LVH-27/S3-ROV/2016/stream_site/01/files/pic01.jpg

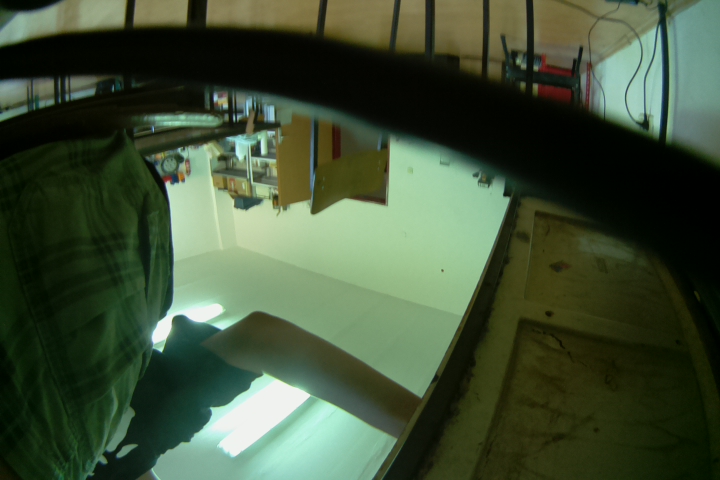
2016/stream_site/01/files/pic01.jpg
