LVH-27/S3-ROV/skladiste/s3 2015/C-ROV.pptx

## C-ROV

Sea Remotely Operated Vehicle

Luka Banović, Nikola Banović, Lovro Boban, Marko Lazarić

Mentori:
Danko Marušić, Dominik Barbarić

## Cilj

- Izrada ROV-a (Remotely Operated Vehicle)
  - Kućište i motori
  - Software
  - Hardware (elektronički sklopovi)
- Primjena:
  - Istraživanje morskog dna (Bromboli, ušće Mirne...)

Sustav za kontrolu

## Kućište

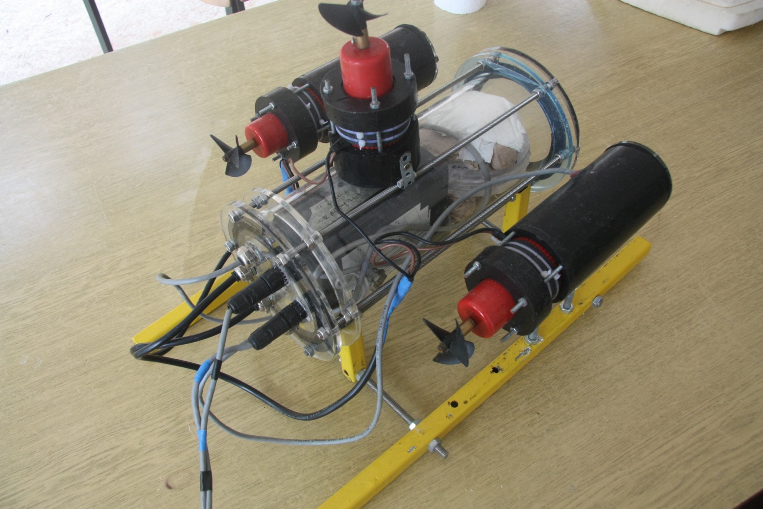
[picture p3: figure]

Gornji motor

Trup

Bočni motor

Postolje

Slika 1. Dijelovi kućišta ROV-a

Ethernet kabel

## Slide 4

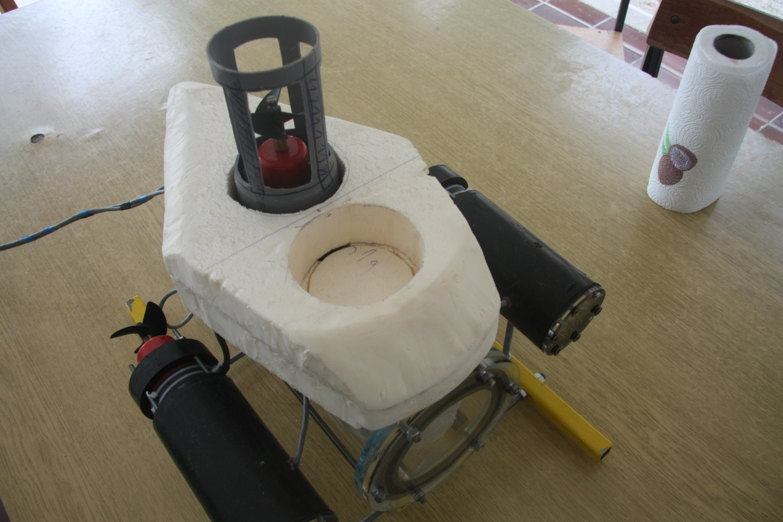
[picture p4: figure]

Slika 2. Stiroporom se prilagođava gustoća podmornice

## Sustav za kontrolu ROV-a

PC

Raspberry Pi

Arduino

Motor

Relej

Electronic Speed Controller (ESC)

Slika 3. Shema sustava za kontrolu ROV-a

## Raspberry Pi

- Server, C++
- Pokret gljivica na joysticku = 3 broja koja određuju brzinu i smjer ROV-a

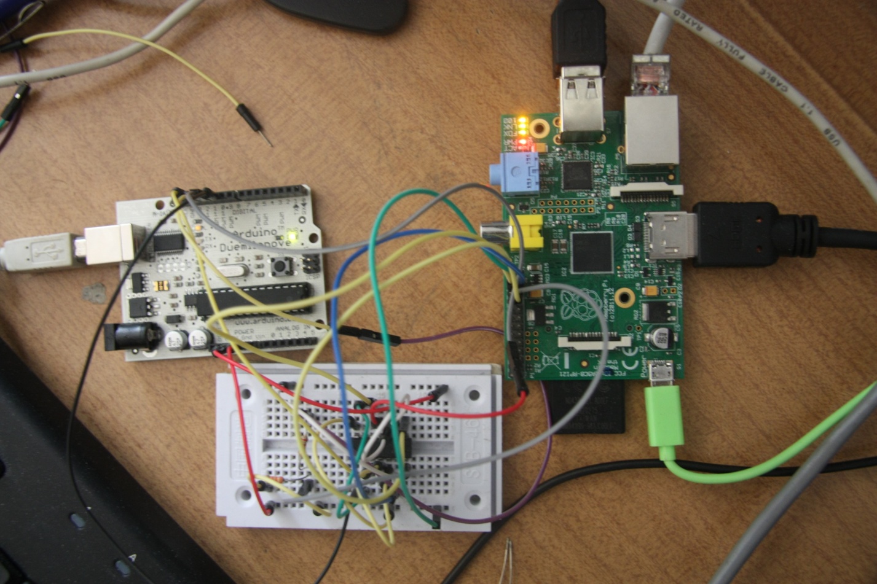
[picture p5: figure]

Slika 9. Raspberry Pi i Arduino spojeni za SPI komunikaciju

## Hardver

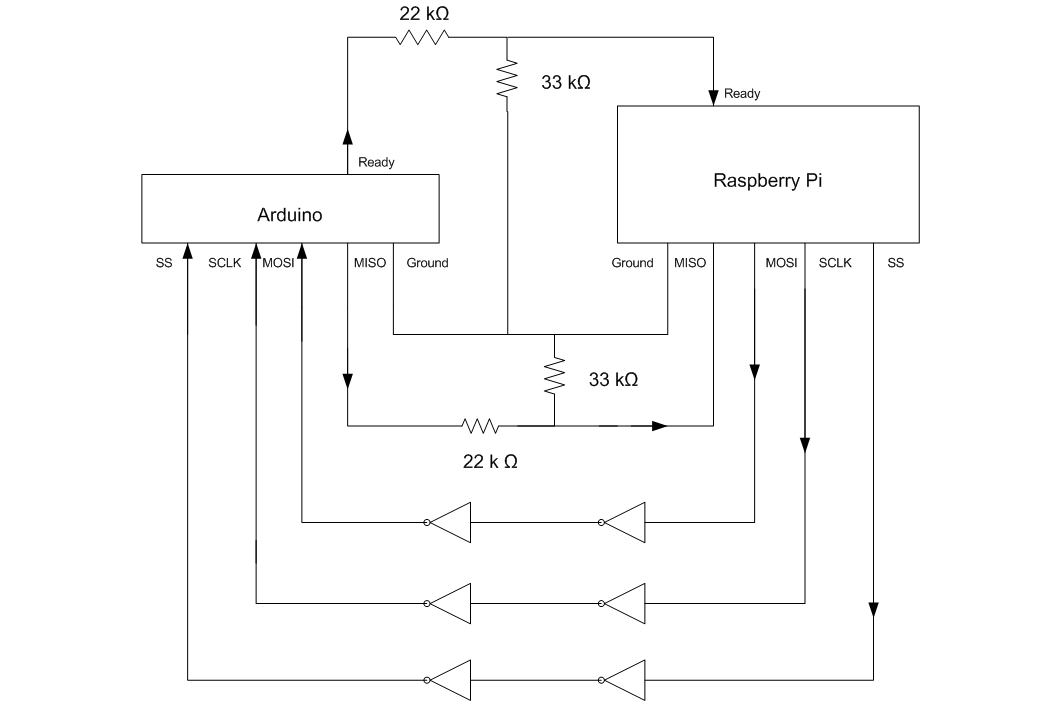
[picture p6: figure]

Slika 4. Komunikacija Arduina i Raspberry Pija

Problem: Arduino i Raspberry Pi ne rade na istom naponu

## Hardver

Problem: ESC ne može mijenjati smjer

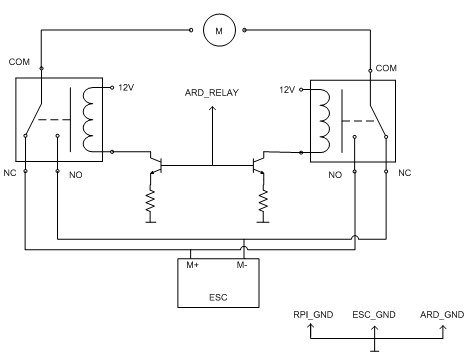
[picture p7: figure]

Slika 5. Shematski prikaz kontrole smjera ROV-a

## Slide 9

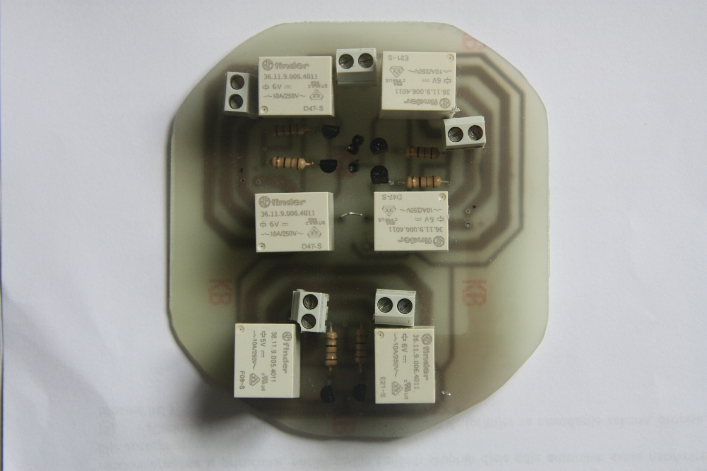
[picture p8: figure]

Slika 8. Tiskana pločica za releje

## Arduino

- Kontrola brzine i smjera ROV-a

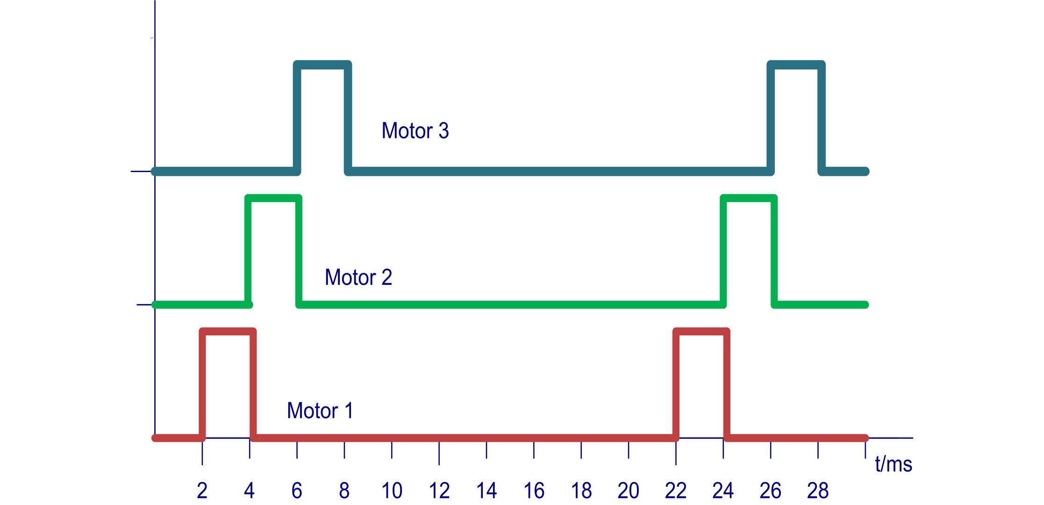
[picture p9: figure]

Slika 10. Grafički prikaz upravljačkih signala za ESC-ove

## Što dalje radimo?

- Izrada tiskane pločice za povezivanje RPi-a i Arduina
- Ispitivanje upravljačkog sustava ROV-a
- Ispitivanje kamere
- Balansiranje ROV-a u morskoj vodi
- Senzorika

## Pitanja?
