LVH-27/S3-ROV/skladiste/s3 2015/ROV - final.pdf

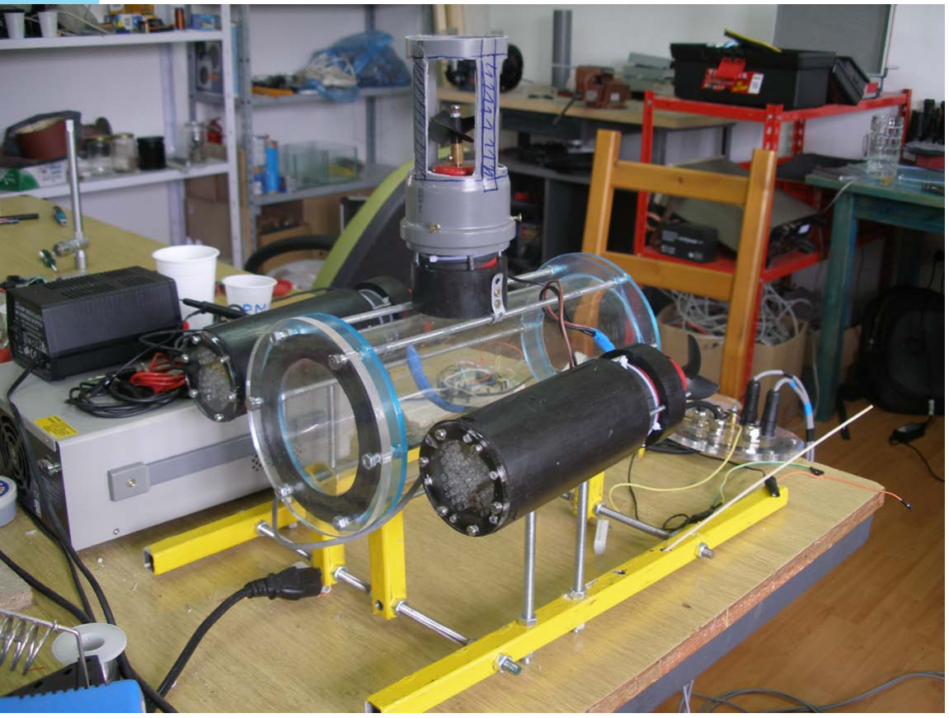
[picture p16: figure]

# ROV

Tara Šverko, Jakov
Jelenić, Daniel Silađi
Mentori: Danko Marušić,
Dominik Barbarić

## Što radimo i što su nam ciljevi?

- Pravljenje ROV-a (Remotely Operated Vehicle), operativnog na dubinama do 30m
- 3 dijela:
- Hardware
- Elektronika
- Software
- Primjena: istraživanje morskog dna

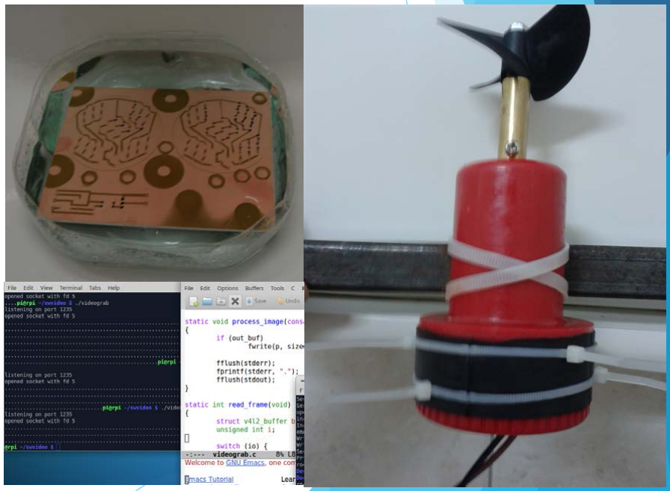
[picture p17: figure]

## Hardware

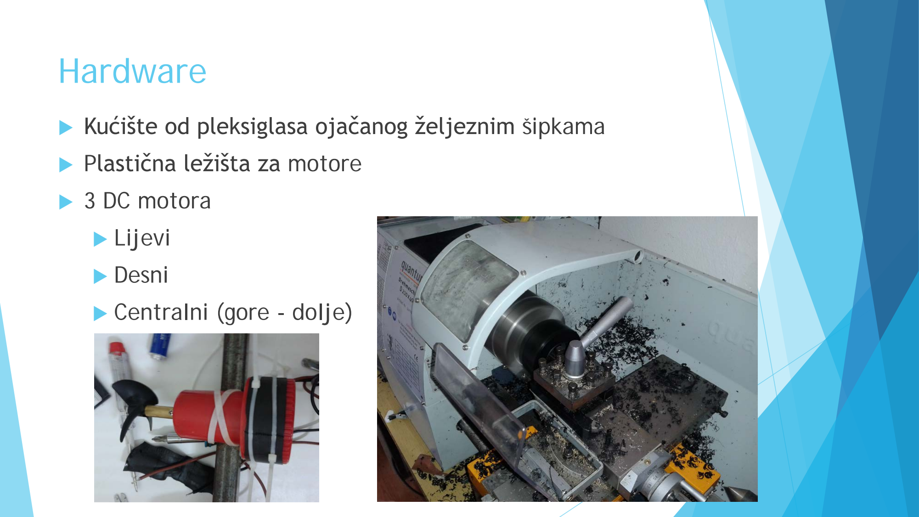
[picture p18: page 3]

- Kućište od pleksiglasa ojačanog željeznim šipkama
- Plastična ležišta za motore
- 3 DC motora
- Lijevi
- Desni
- Centralni (gore - dolje)

## Izazovi

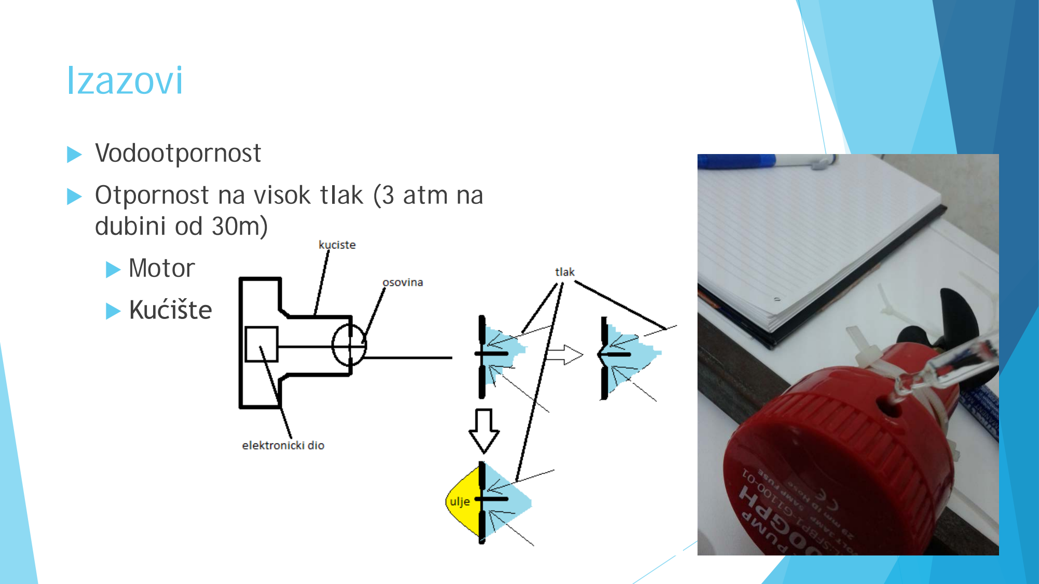
[picture p19: page 4]

- Vodootpornost
- Otpornost na visok tlak (3 atm na dubini od 30m)
- Motor
- Kućište

## Testiranje hardwarea

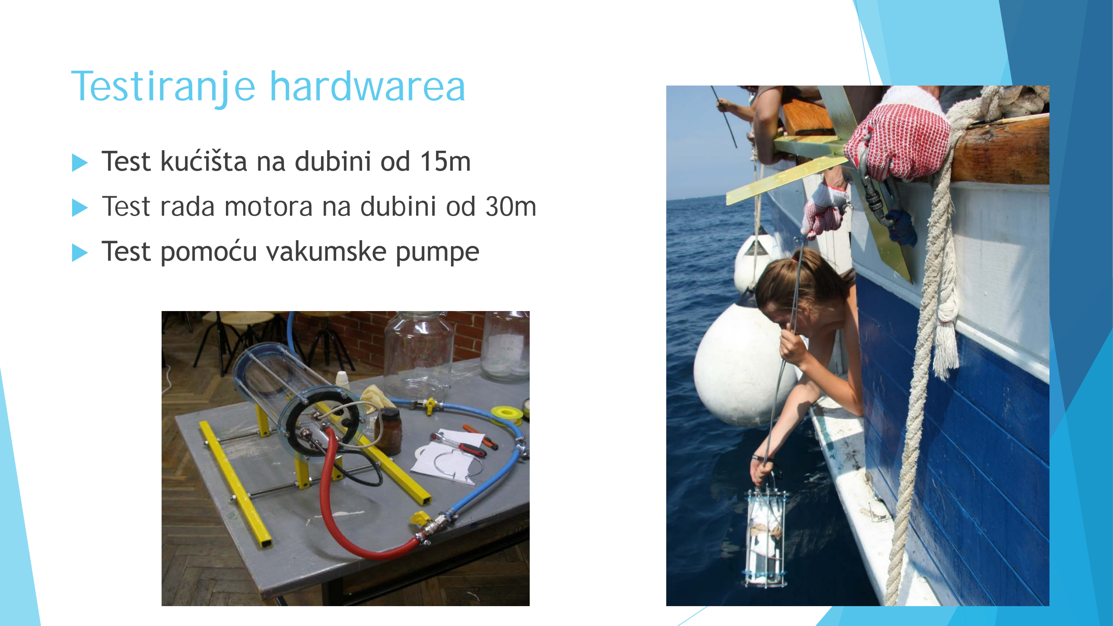
[picture p20: page 5]

- Test kućišta na dubini od 15m
- Test rada motora na dubini od 30m
- Test pomoću vakumske pumpe

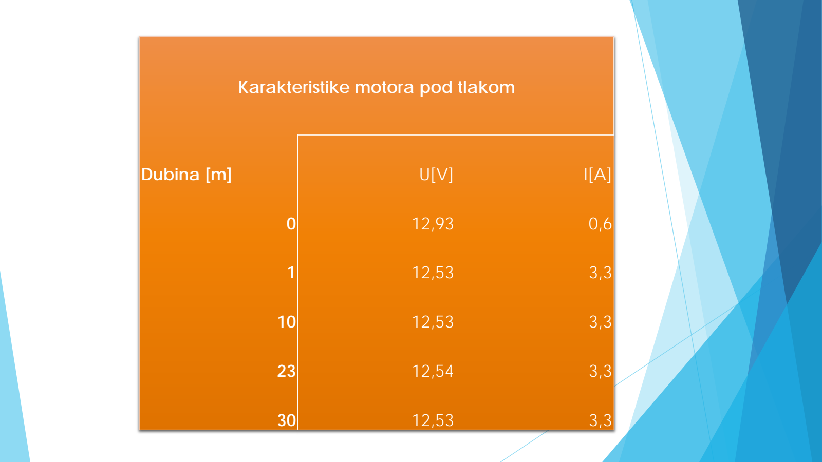
[picture p21: page 6]

Karakteristike motora pod tlakom

Dubina [m] | U[V] | I[A]
0 | 12,93 | 0,6
1 | 12,53 | 3,3
10 | 12,53 | 3,3
23 | 12,54 | 3,3
30 | 12,53 | 3,3

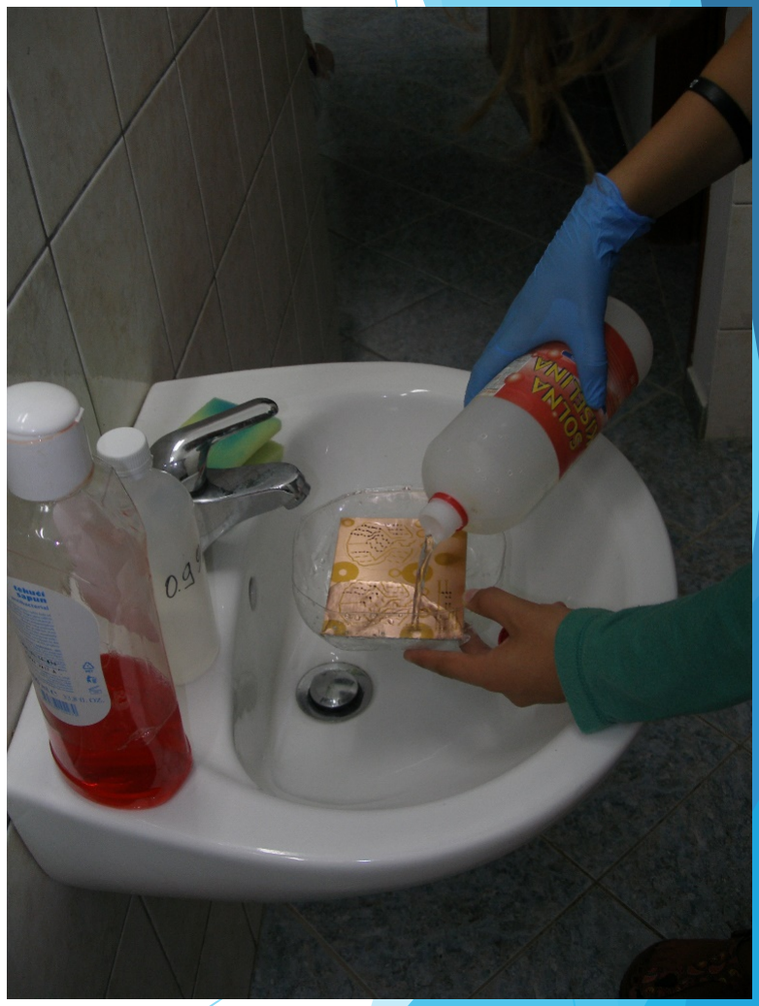
[picture p22: figure]

## Elektronika

- Interface između motora i Raspberry Pi računala
- Potrebno je kontrolirati smjer i brzinu okretanja motora
- Pulse wIdth modulacija
- H – most
- Sami smo izradili svoje PCB-ove
- Dodatna elekronika
- Rasvjeta
- Regulator napona za Raspberry Pi

## Pulse Width Modulation (PWM)

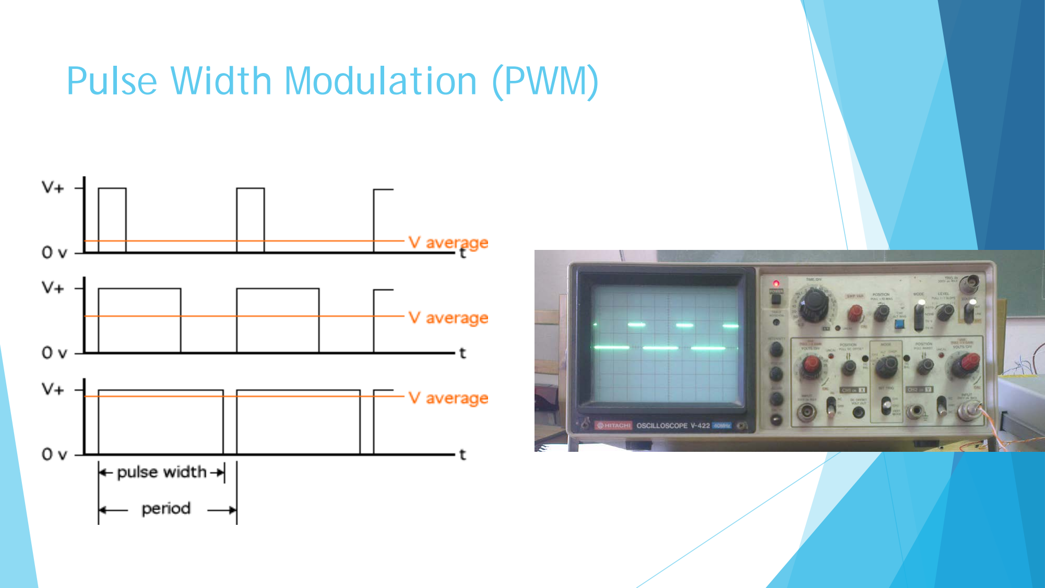
[picture p23: page 8]
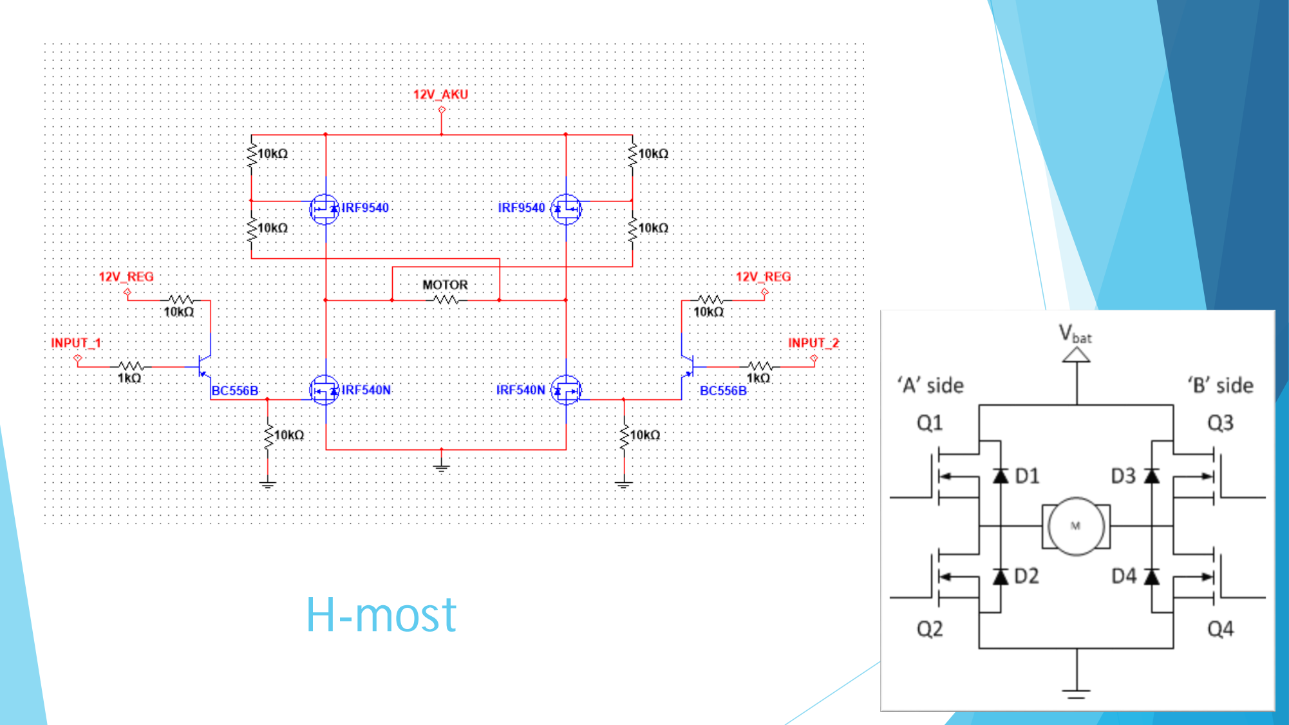
[picture p24: page 9]

## H-most

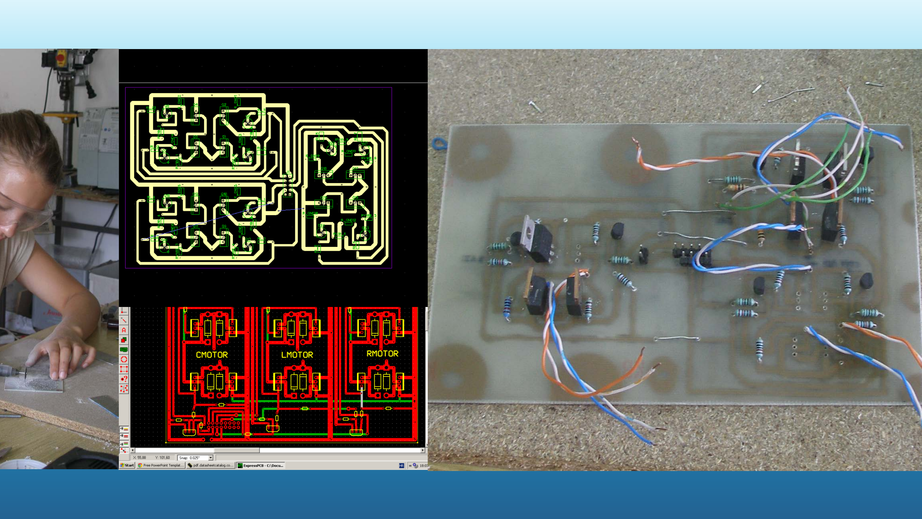
[picture p25: page 10]

## LED rasvjeta

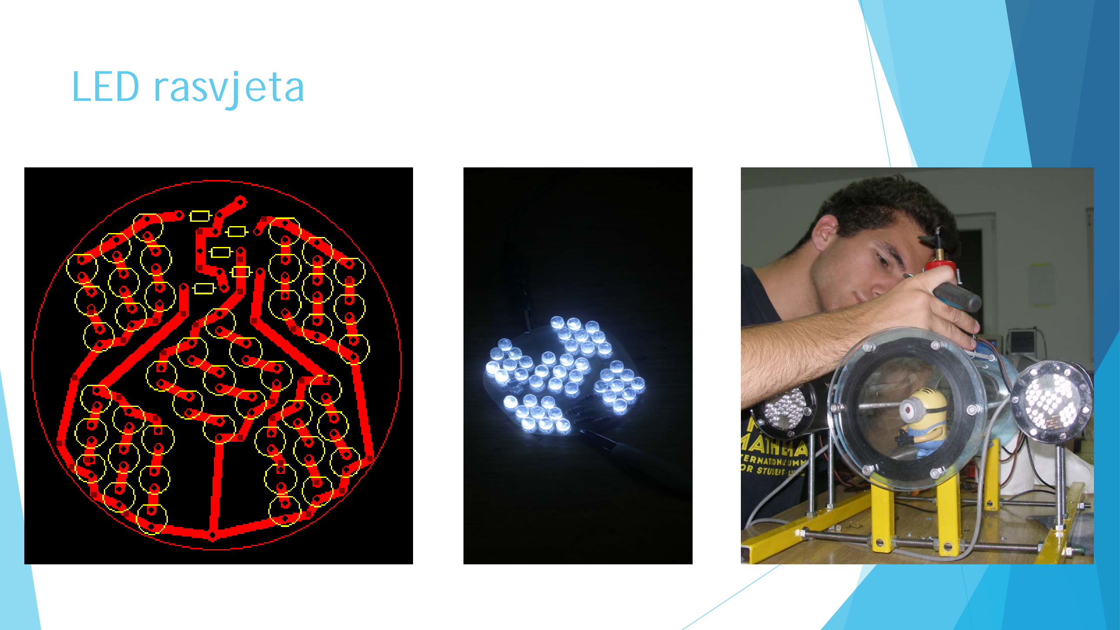
[picture p26: page 11]

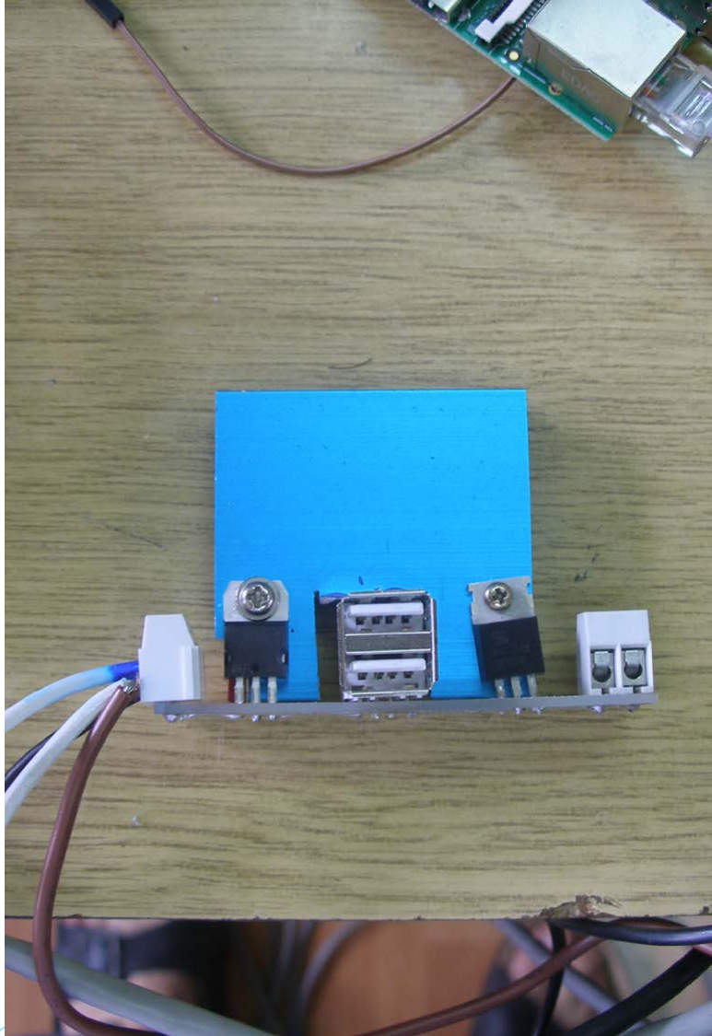
[picture p27: figure]

## Regulator napona

- Napunjeni akumulator nam daje više od 12V
- Regulator nam osigurava stabilnih 12V i stabilnih 5V (za Raspberry Pi)
- Koristili smo sklopove 7805 i 7812

## Software

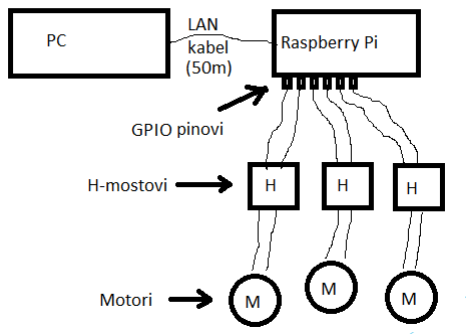
[picture p28: figure]

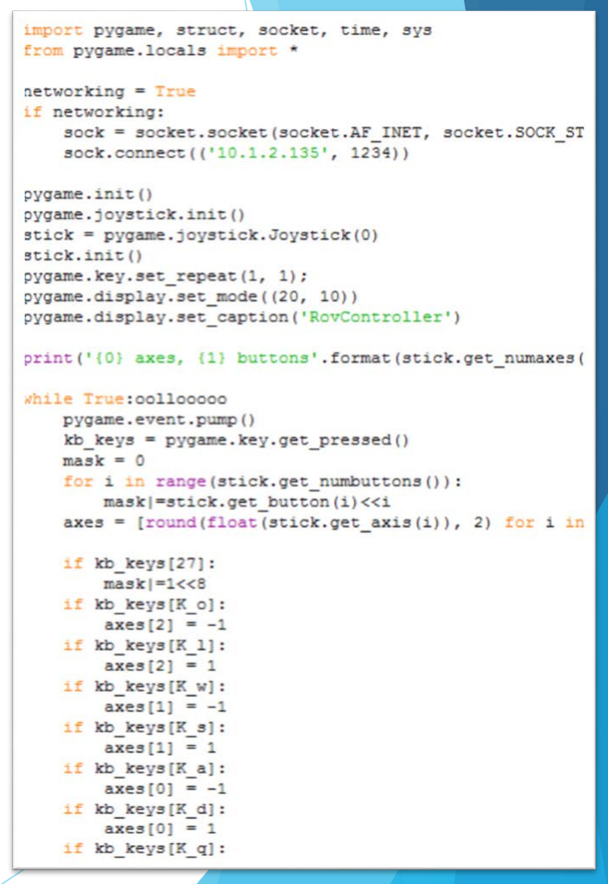
[picture p29: figure]

## Kontroliranje ROV-a

- Klijent – server arhitektura
- Klijent periodično šalje stanje gumbova na joysticku (biblioteka pyGame)
- Server (također periodično) obrađuje te podatke i na osnovu njih pali i gasi motore
- Ukoliko ne želimo pokretati motore punom snagom, šaljemo PW moduliran signal

## Kamera

- Cilj je da ROV prenosi livestream koji će olakšati upravljanje i navigaciju
- Idealno bi bilo prenositi video u HD rezoluciji, pri bar 30fps
- Ograničeni smo brzinom Ethernet kabla (100Mbps) i procesorskom snagom Rpi (ARM11@700Mhz)
- Kompromis: nekompresirani VGA video pri 15fps
- Sav prijenos podataka se vrši preko TCP

## Planovi za dalji rad

- Kratkoročni
- Izraditi novi elektronski sklop na tiskanoj pločici
- Hardversko enkodiranje videa sa web kamere
- Dugoročni
- Primjena u istraživanjima
- Adaptiranje kućišta na veće dubine i ostale posebne uvjete
- Povezivanje sa prošlogodišnjim projektom izrade robotske ruke

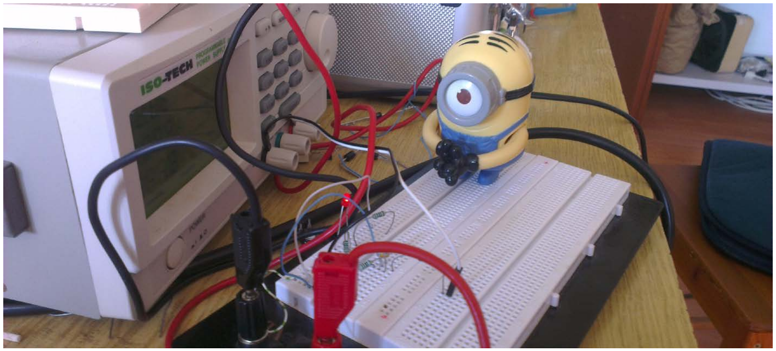
[picture p30: figure]

Hvala na pažnji, pitanja?
