LVH-27/S3-ROV/skladiste/s3 2015/graf novi.png

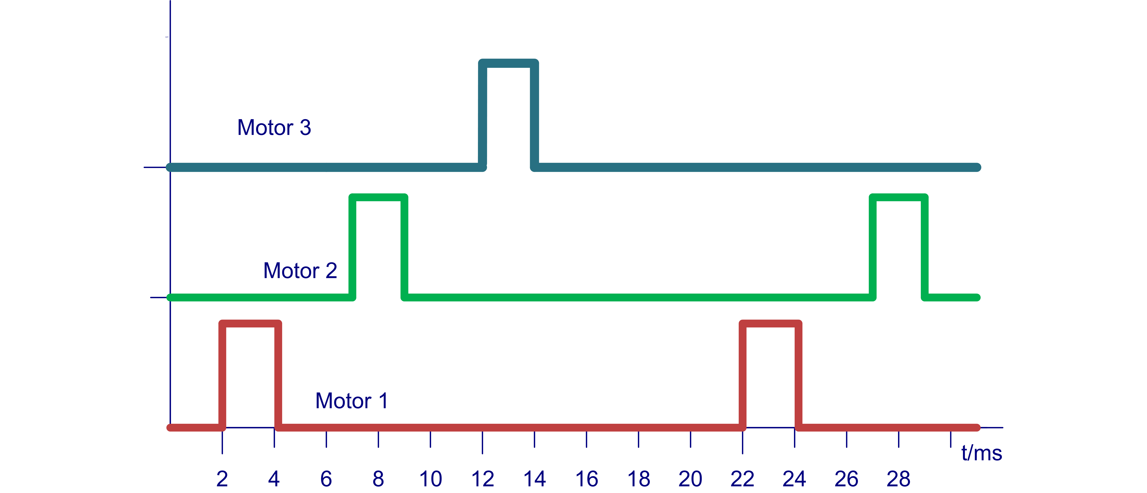
skladiste/s3 2015/graf novi.png
