LVH-27/S3-ROV/skladiste/s3 2015/pico slik/2015_08_04_004.bmp

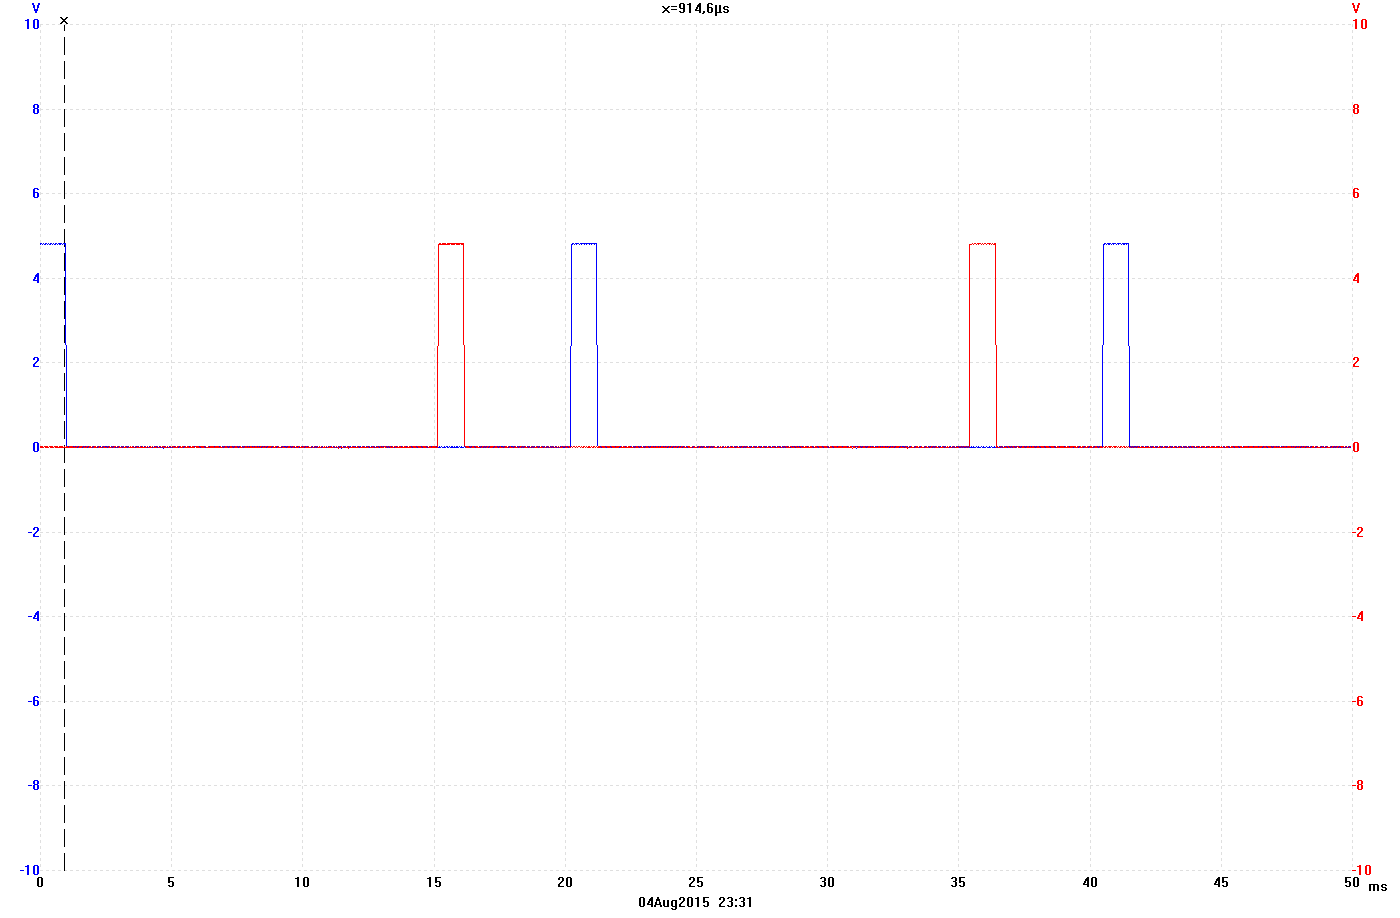
skladiste/s3 2015/pico slik/2015_08_04_004.bmp
