LVH-27/S3-ROV/skladiste/s3 2015/untitled.PNG

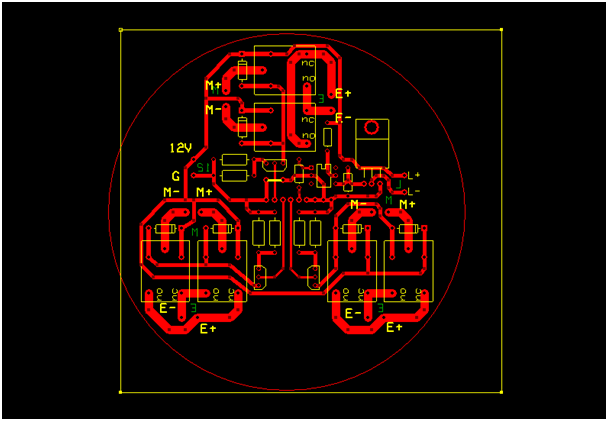
skladiste/s3 2015/untitled.PNG
