LVH-27/S3-ROV/2016/ROV_PCB/Job1.PDF

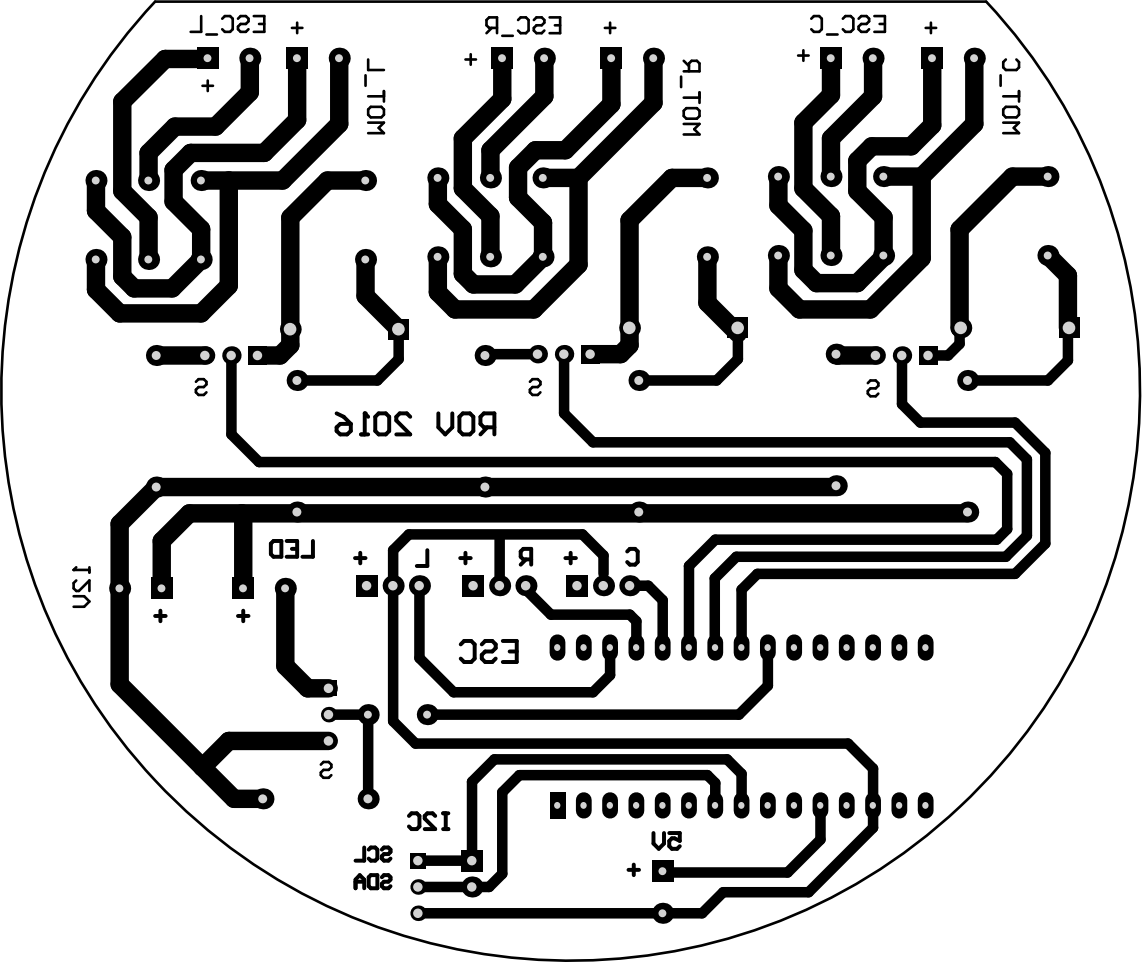
[picture p37: page 1]

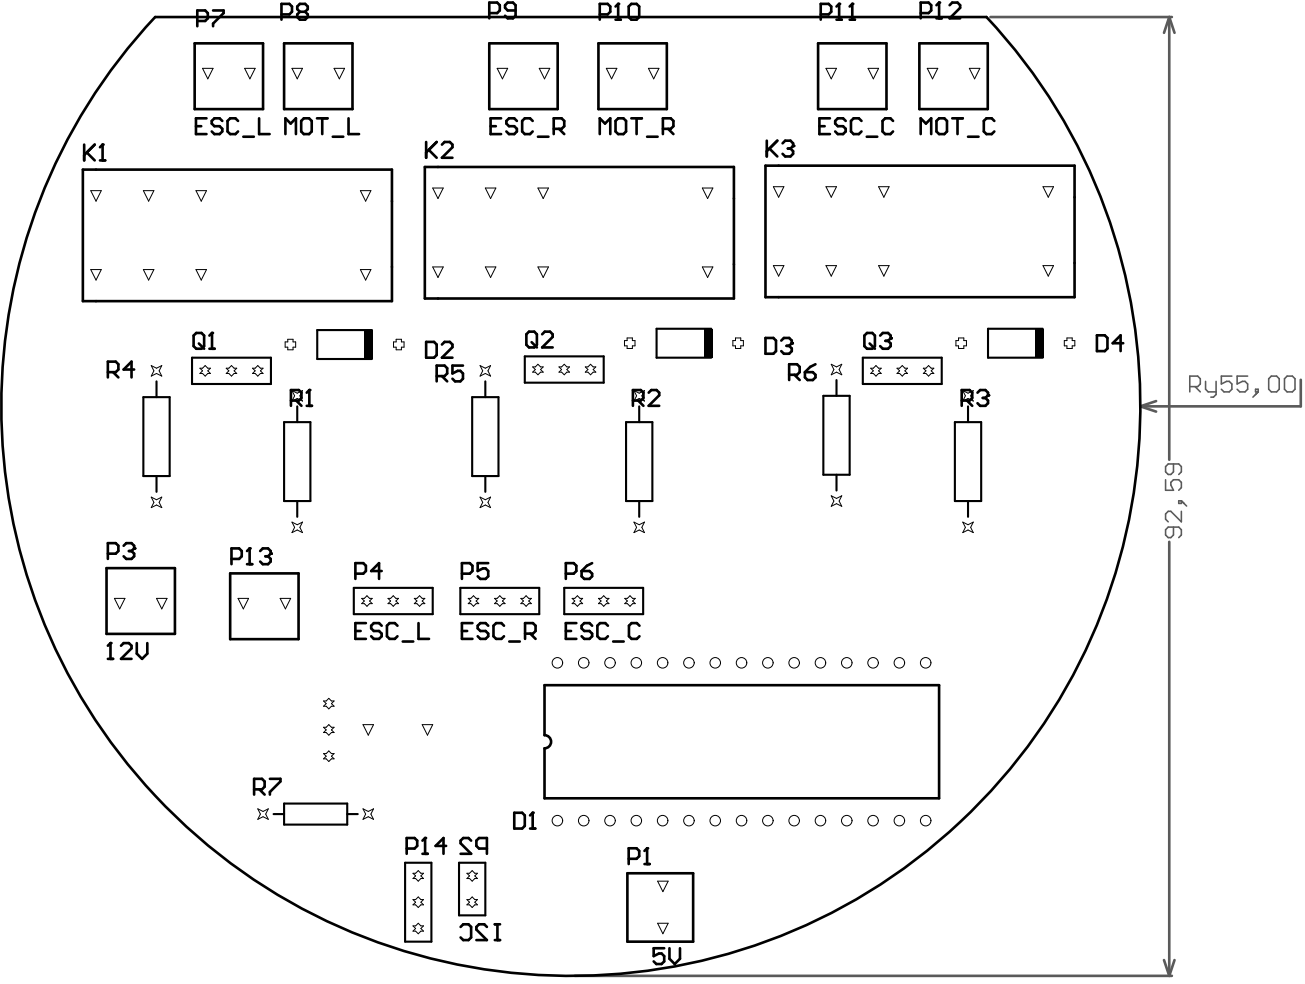
[picture p38: page 2]
