LVH-27/S3-ROV/2016/ROV_PCB/job1_scaled.pdf

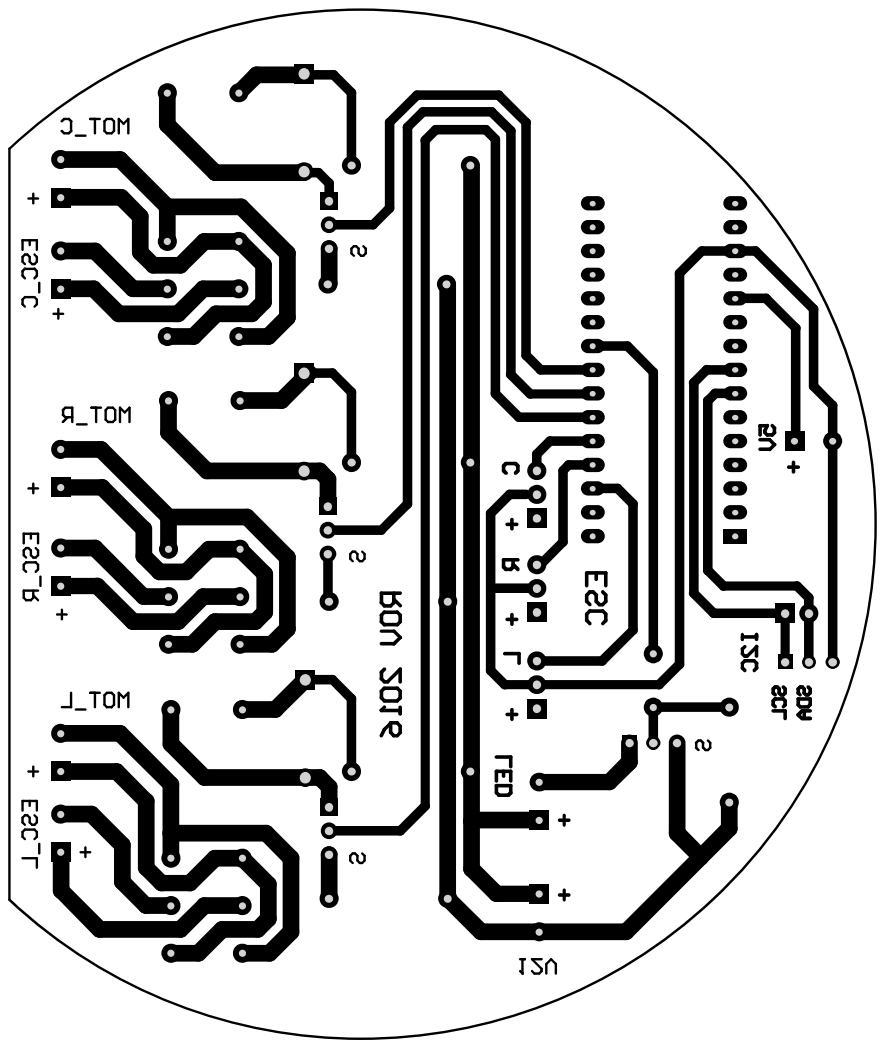
[picture p39: page 1]

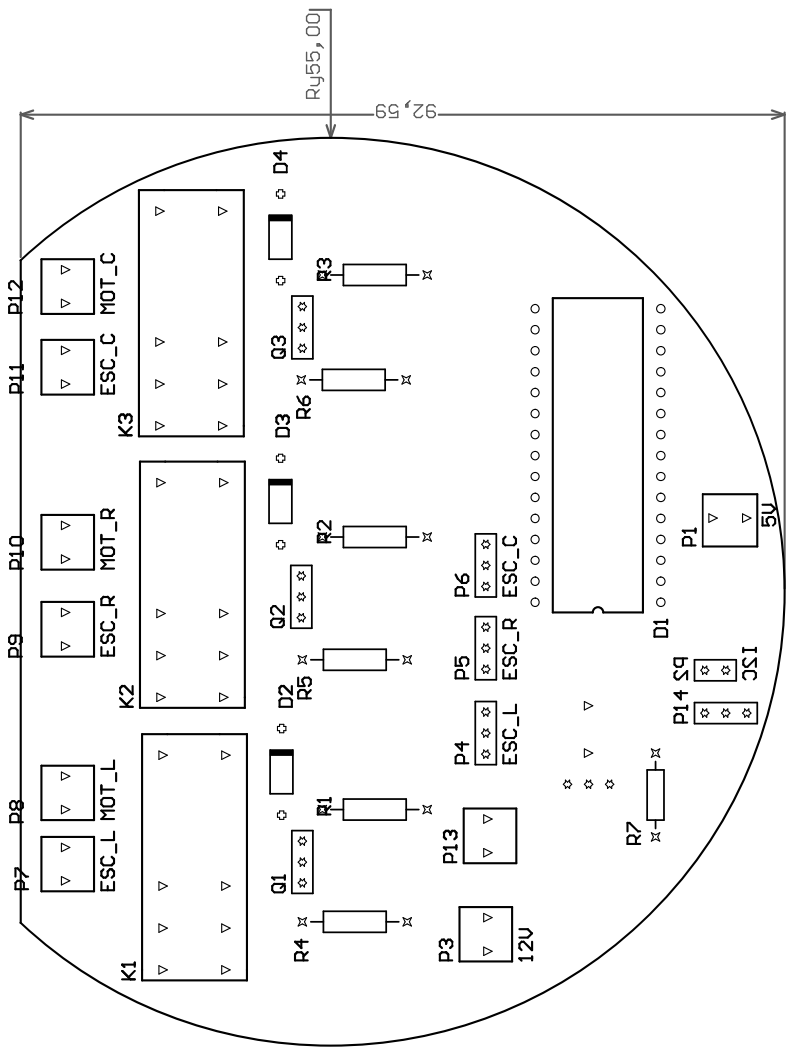
[picture p40: page 2]
