LVH-27/S3-ROV/2017/hw/EDIT-ROV-HEHEHE.PDF

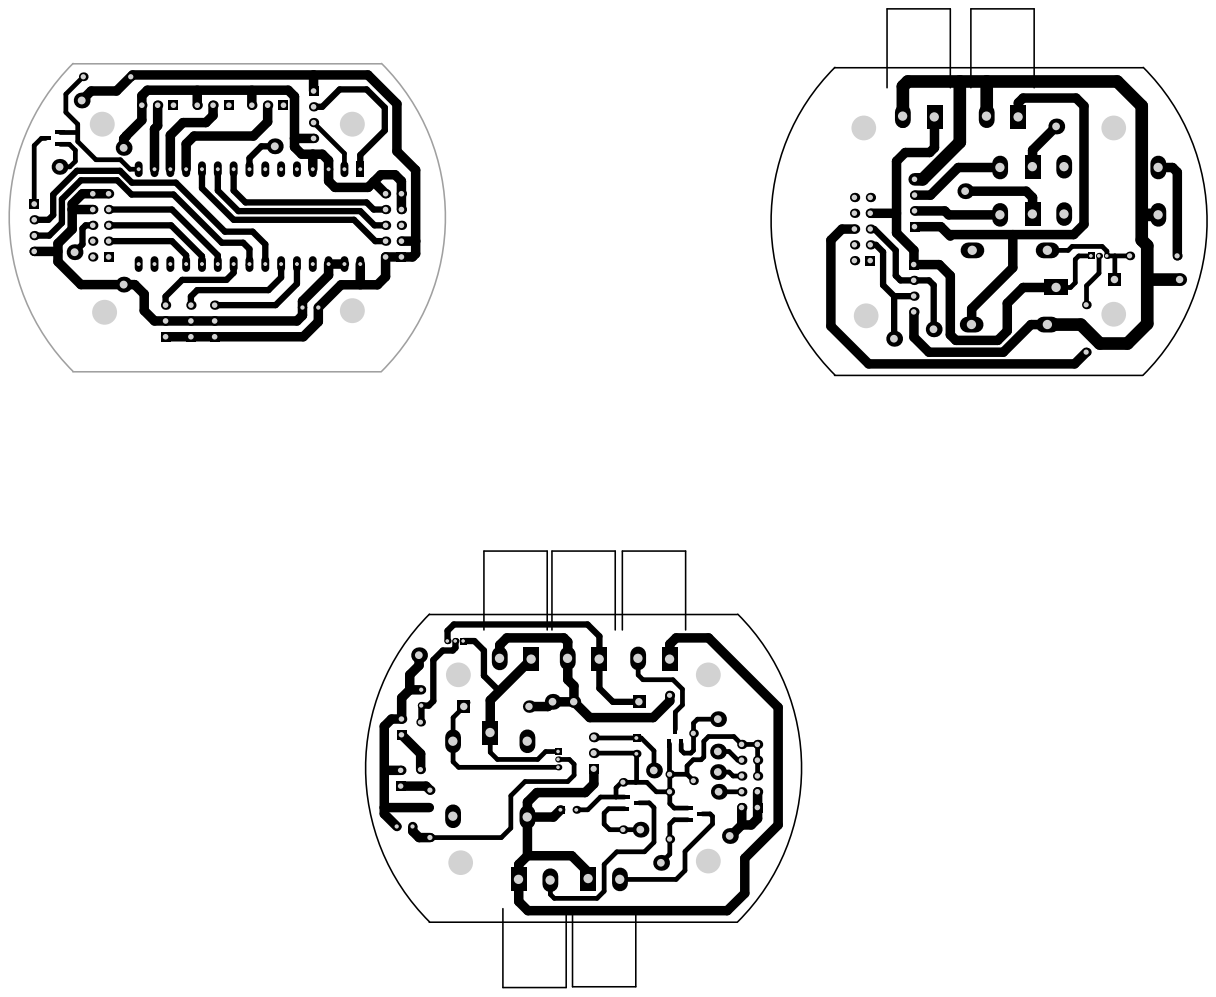
[picture p41: page 1]
