LVH-27/S3-ROV/2017/hw/EDIT-ROV-HEHEHE2.PDF

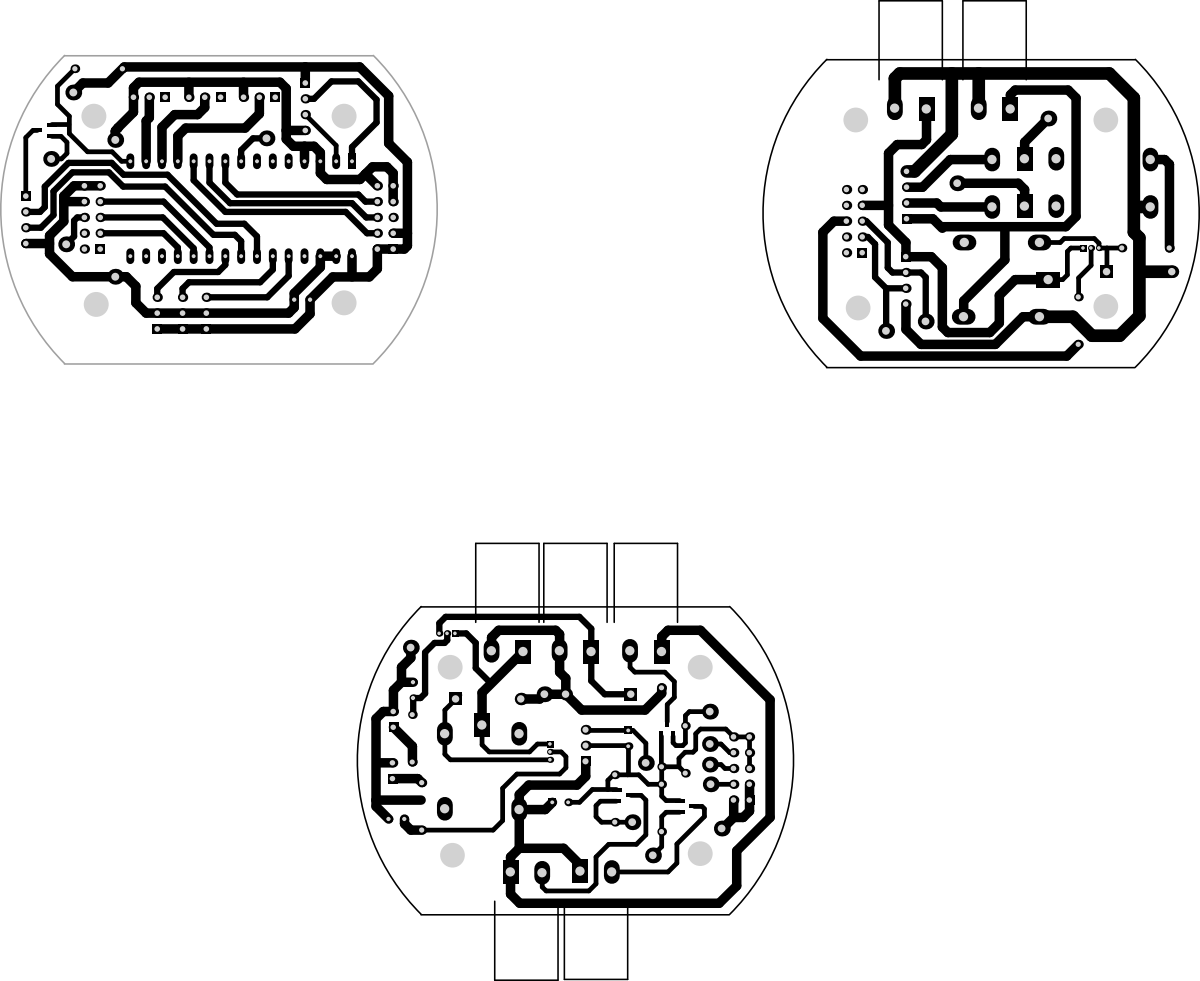
[picture p42: page 1]
