LVH-27/S3-ROV/2017/hw/NO EDIT - ROV/Project Outputs for ROV_PCB_3/Job1.PDF

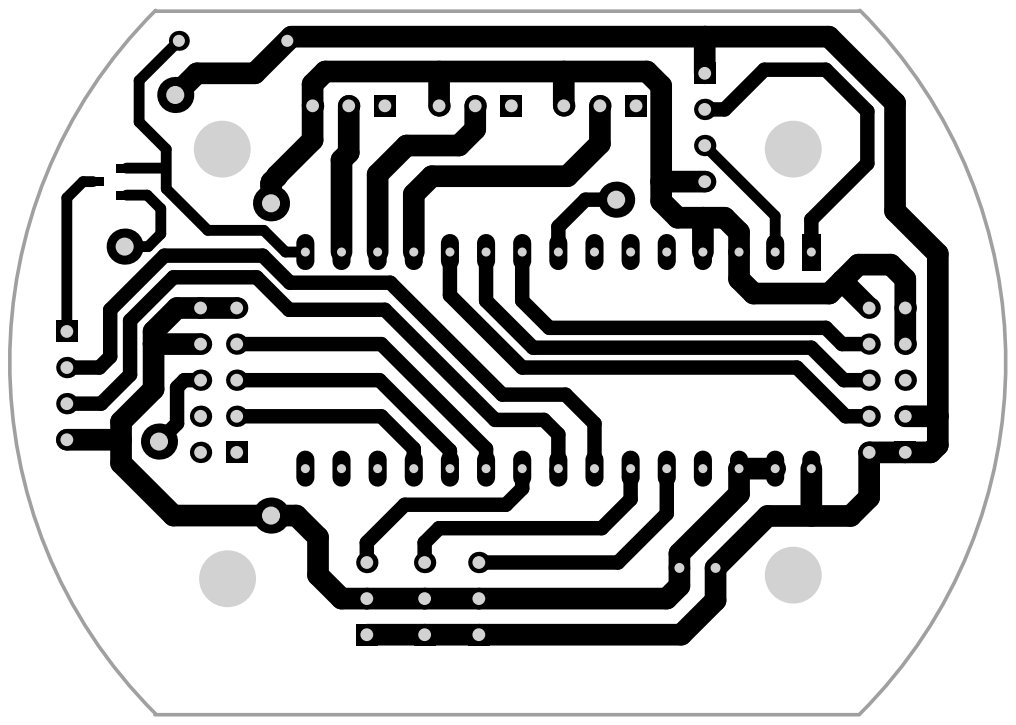
[picture p43: page 1]

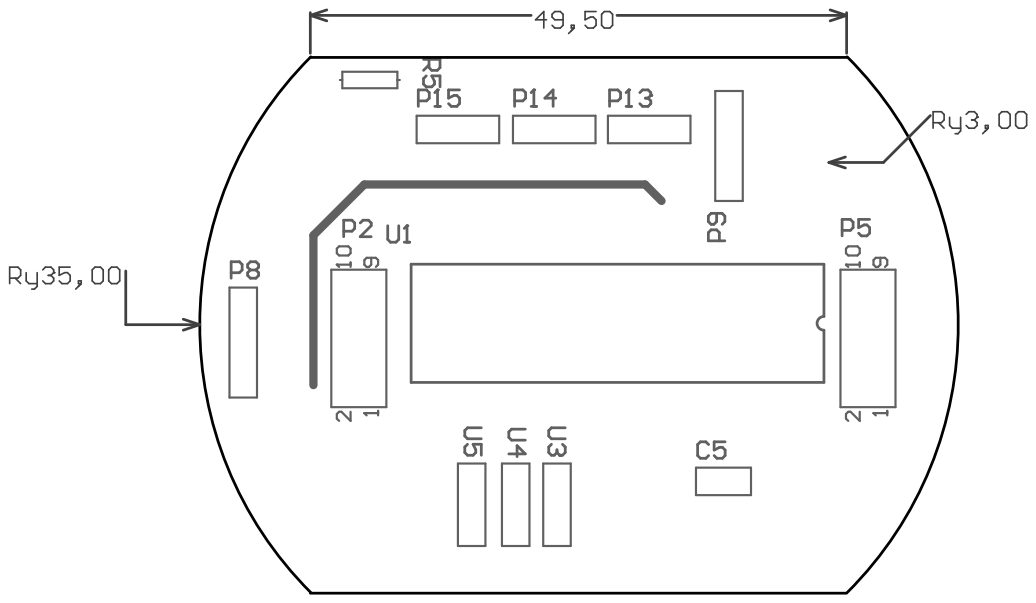
[picture p44: page 2]

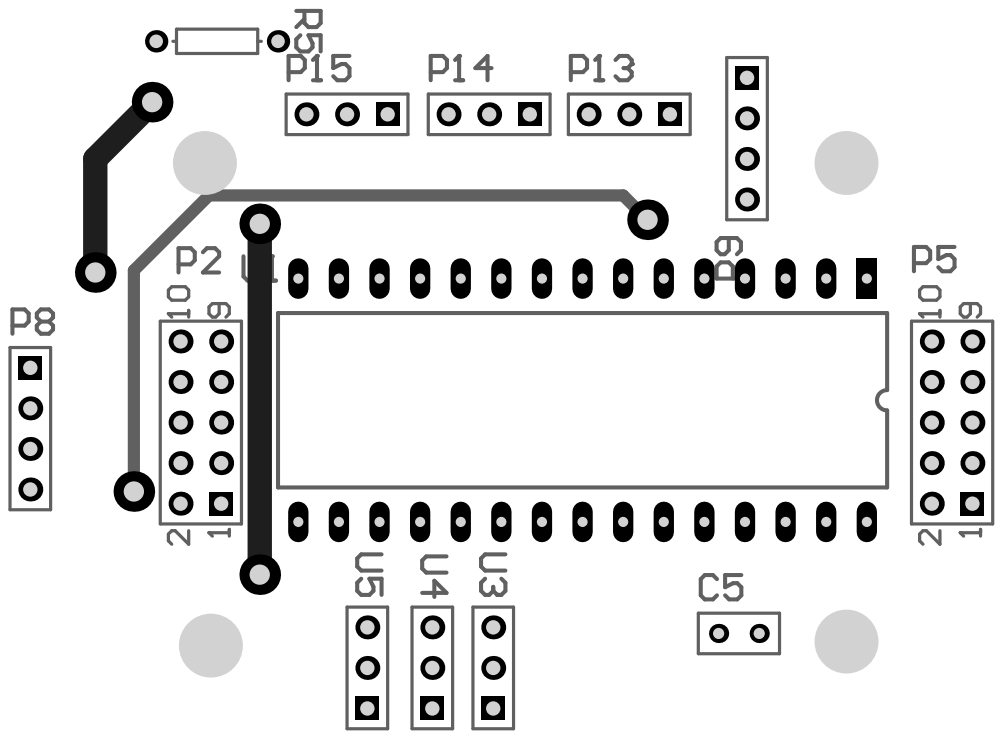
[picture p45: page 3]

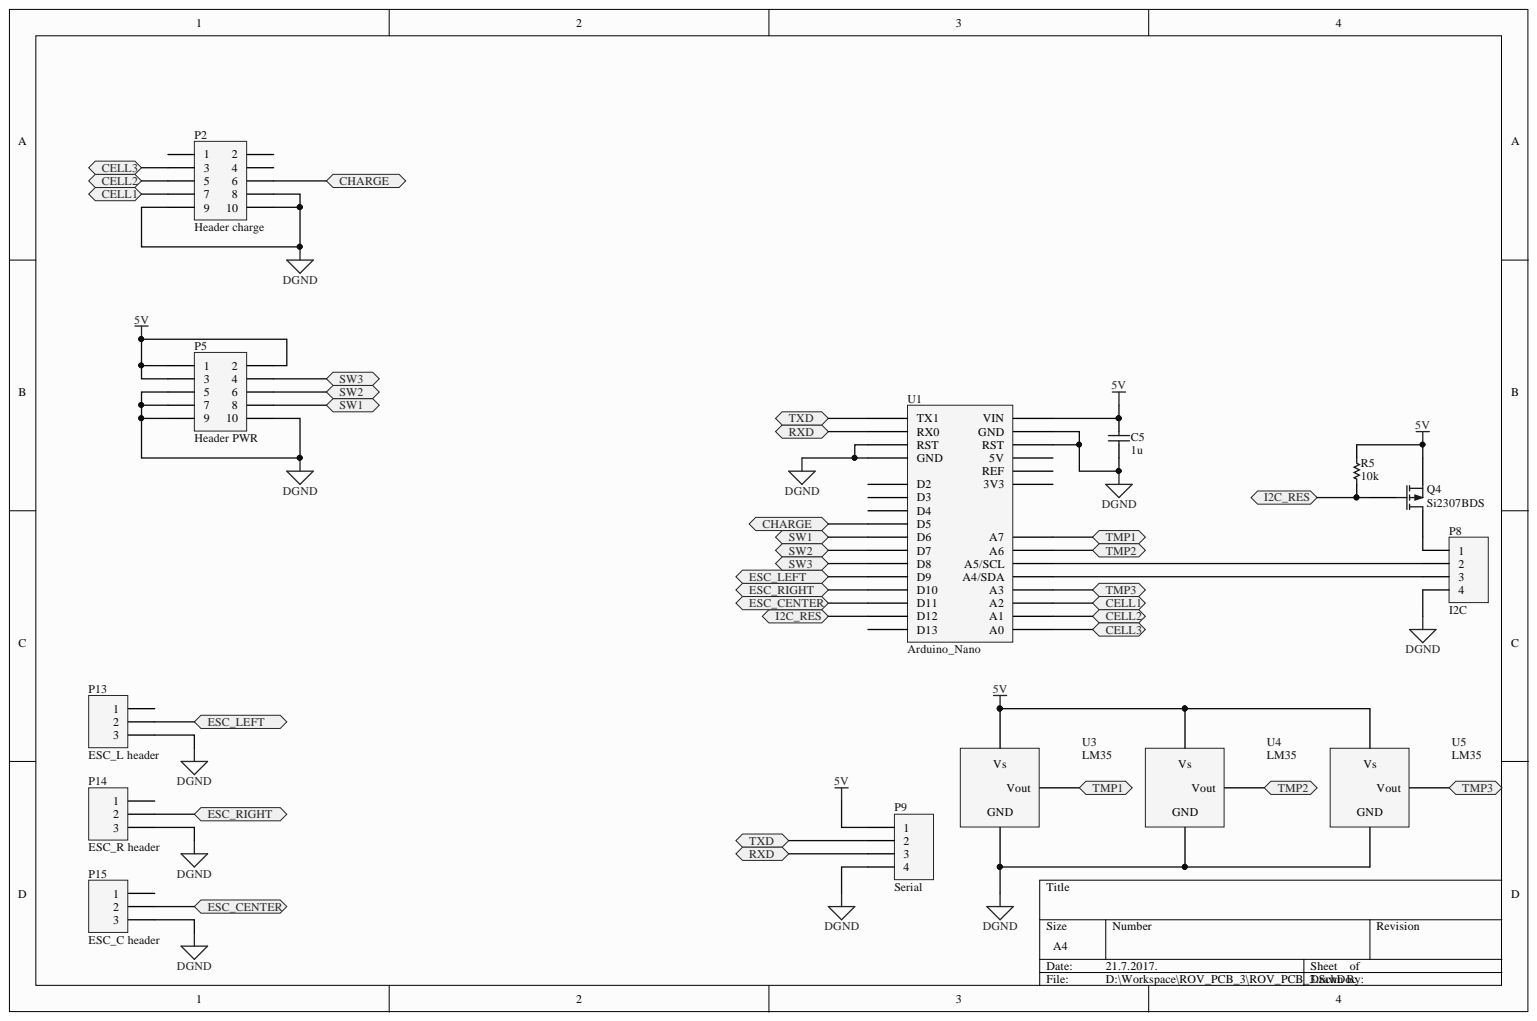
[picture p46: page 4]
