LVH-27/S3-ROV/2017/hw/NO EDIT - ROV/ROV_PCB_CHARGE/Job1.PDF

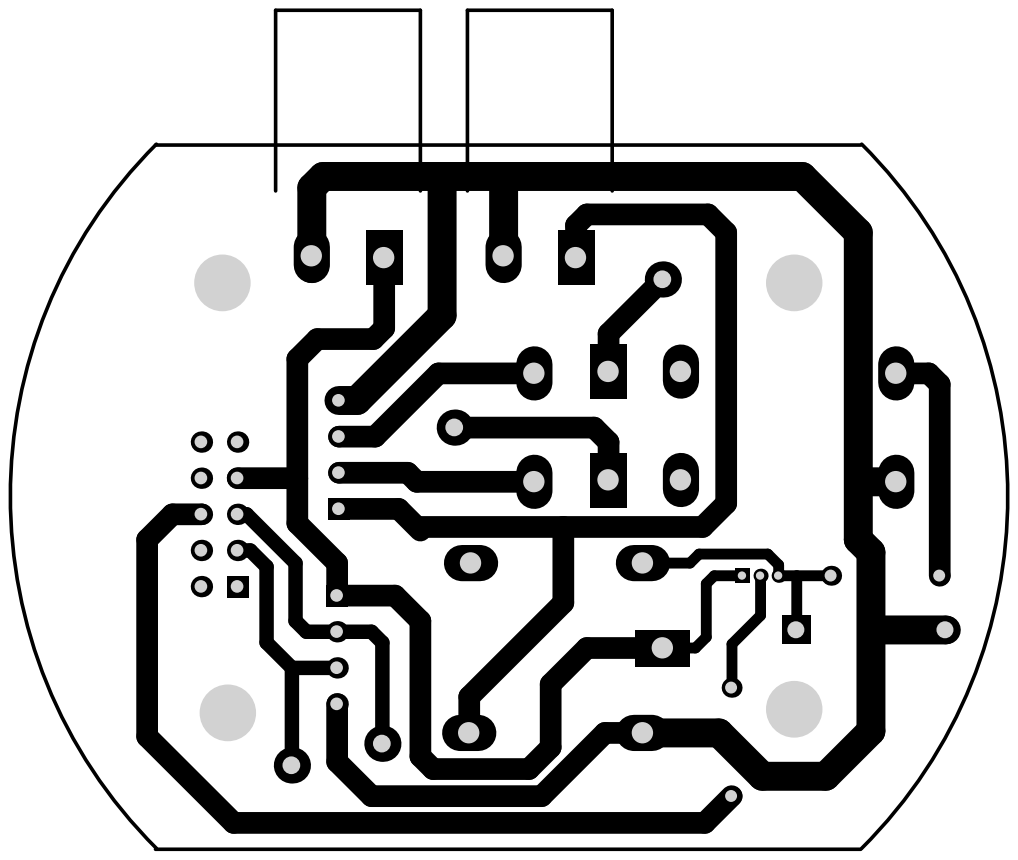
[picture p47: page 1]

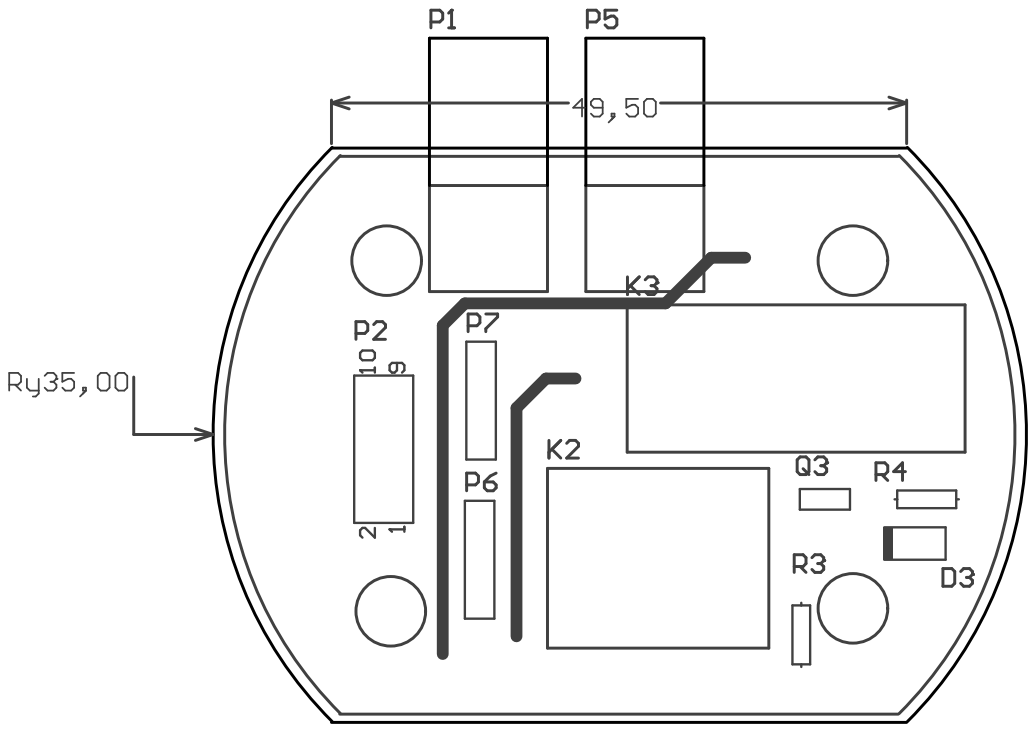
[picture p48: page 2]

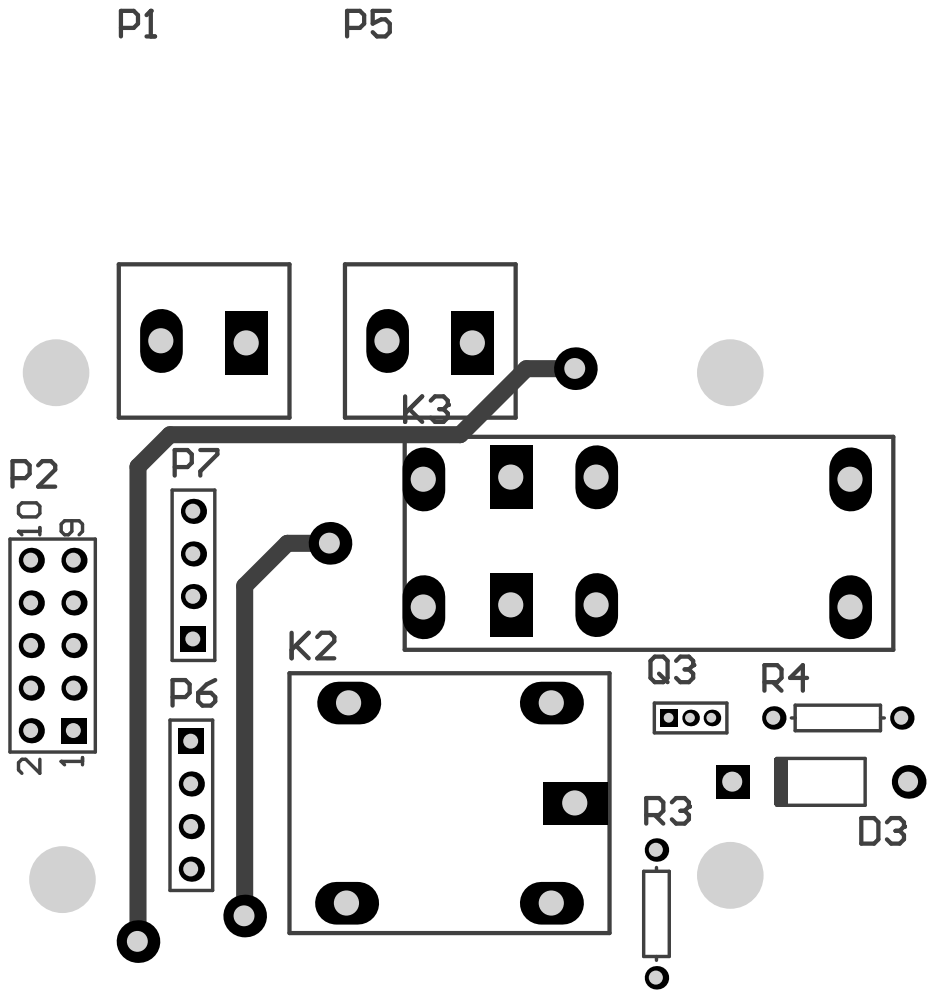
[picture p49: page 3]

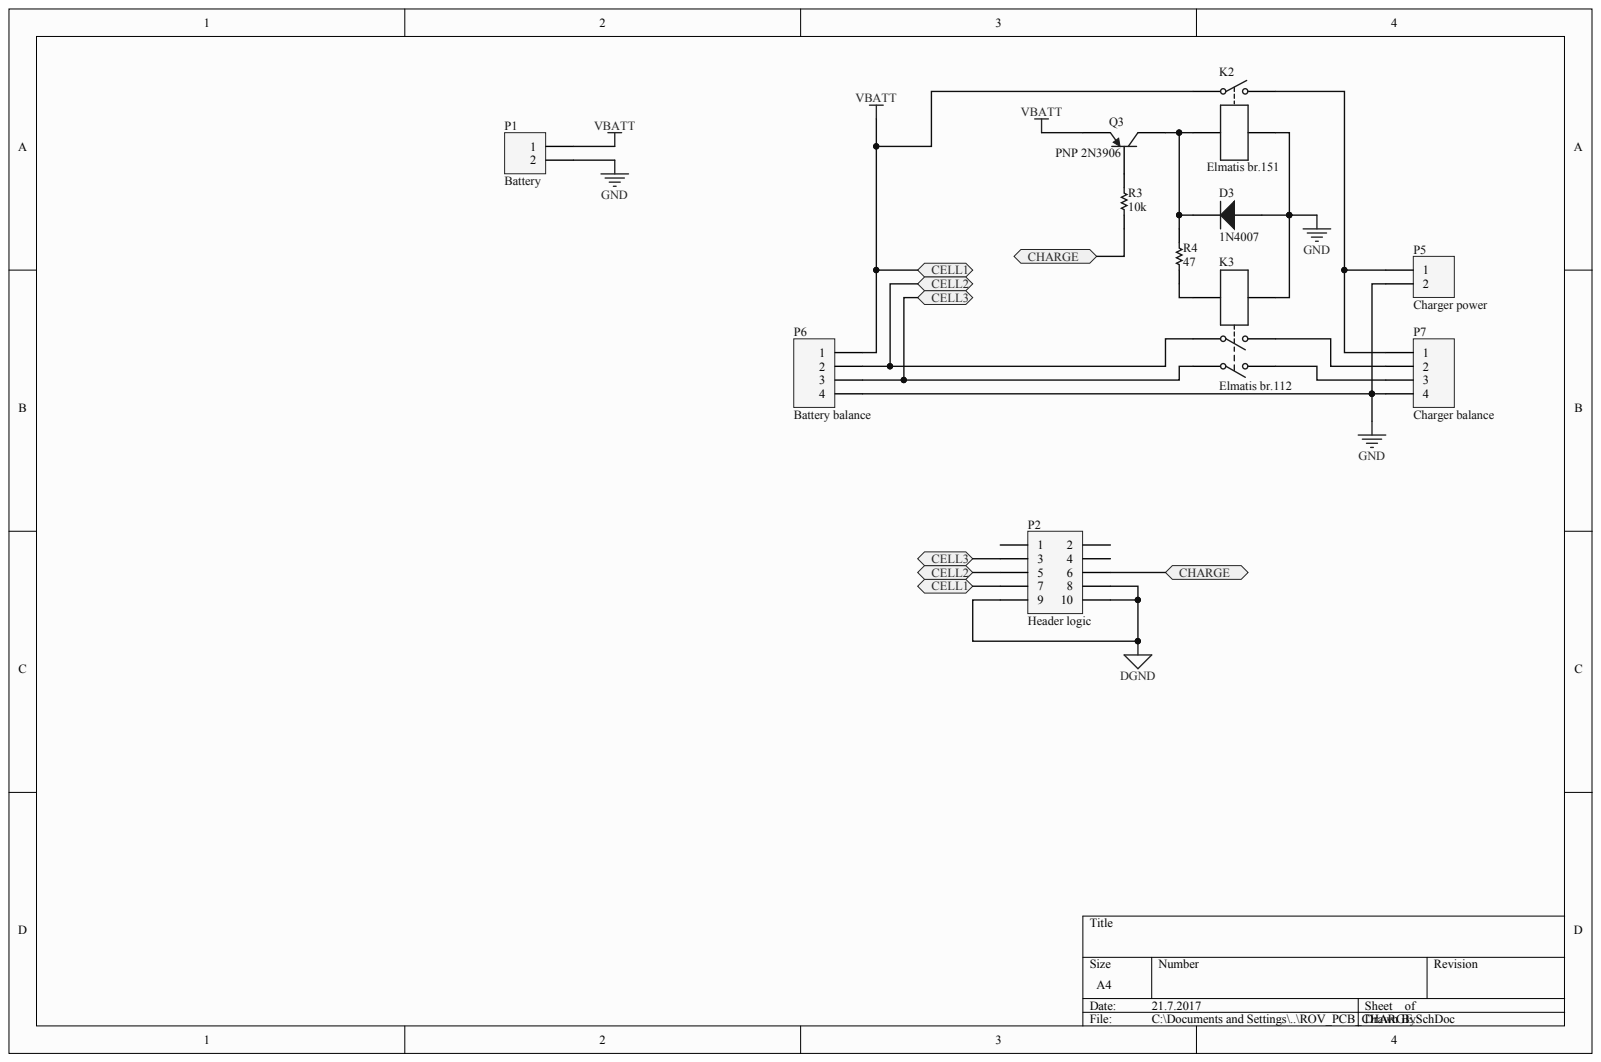
[picture p50: page 4]
