LVH-27/S3-ROV/2017/hw/NO EDIT - ROV/ROV_PCB_PWR/Job1.PDF

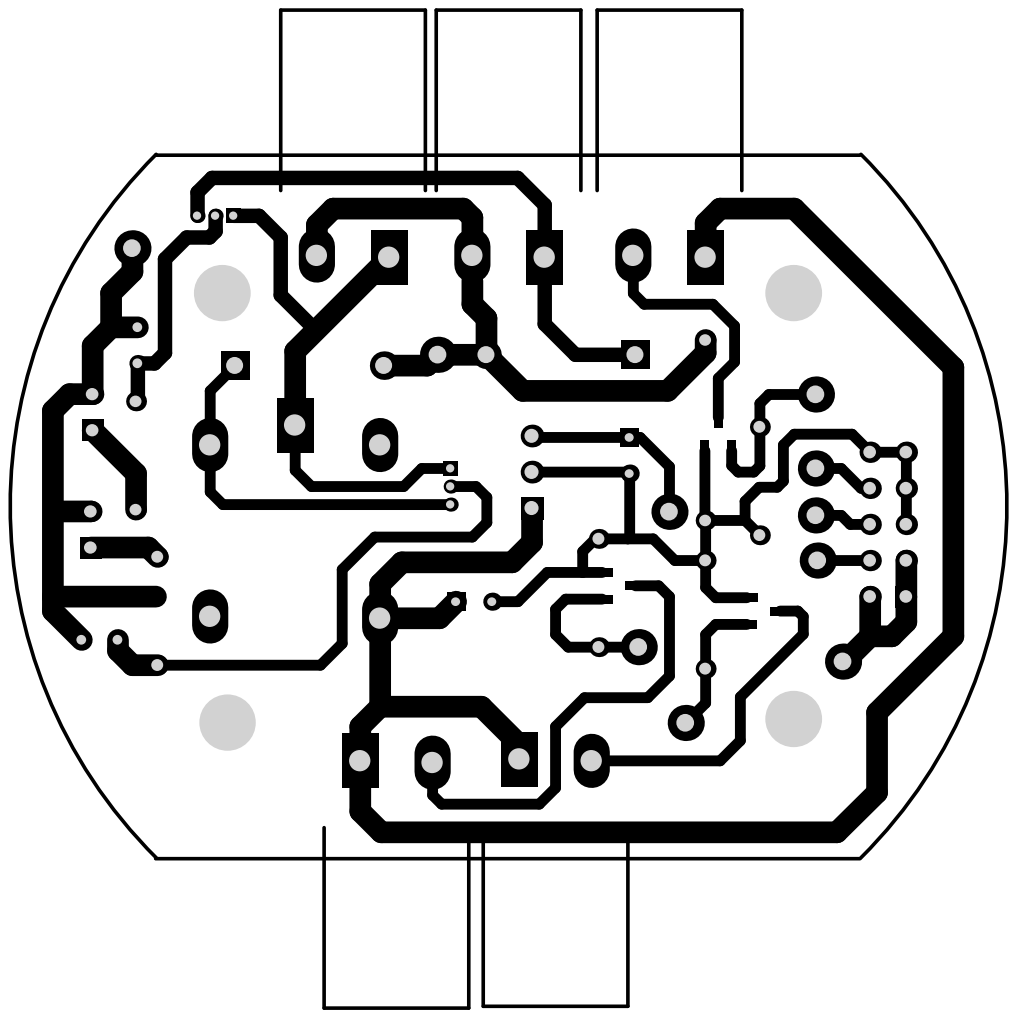
[picture p51: page 1]

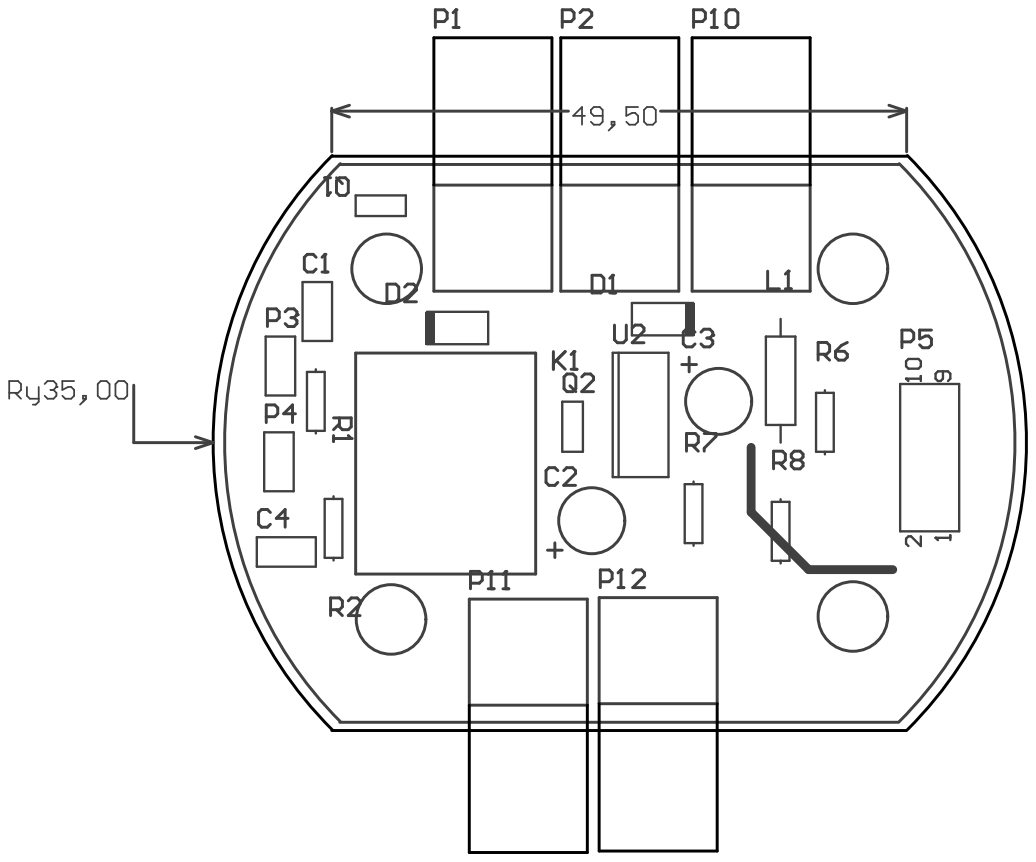
[picture p52: page 2]

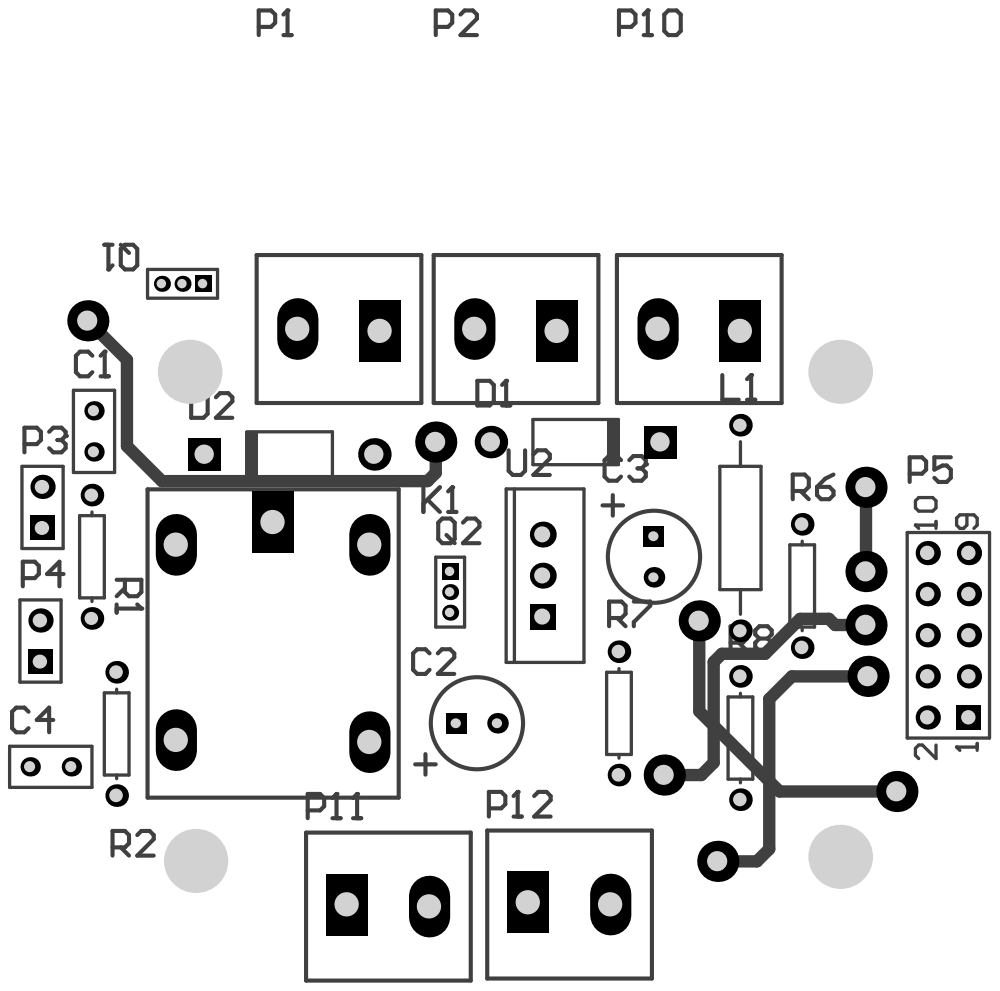
[picture p53: page 3]

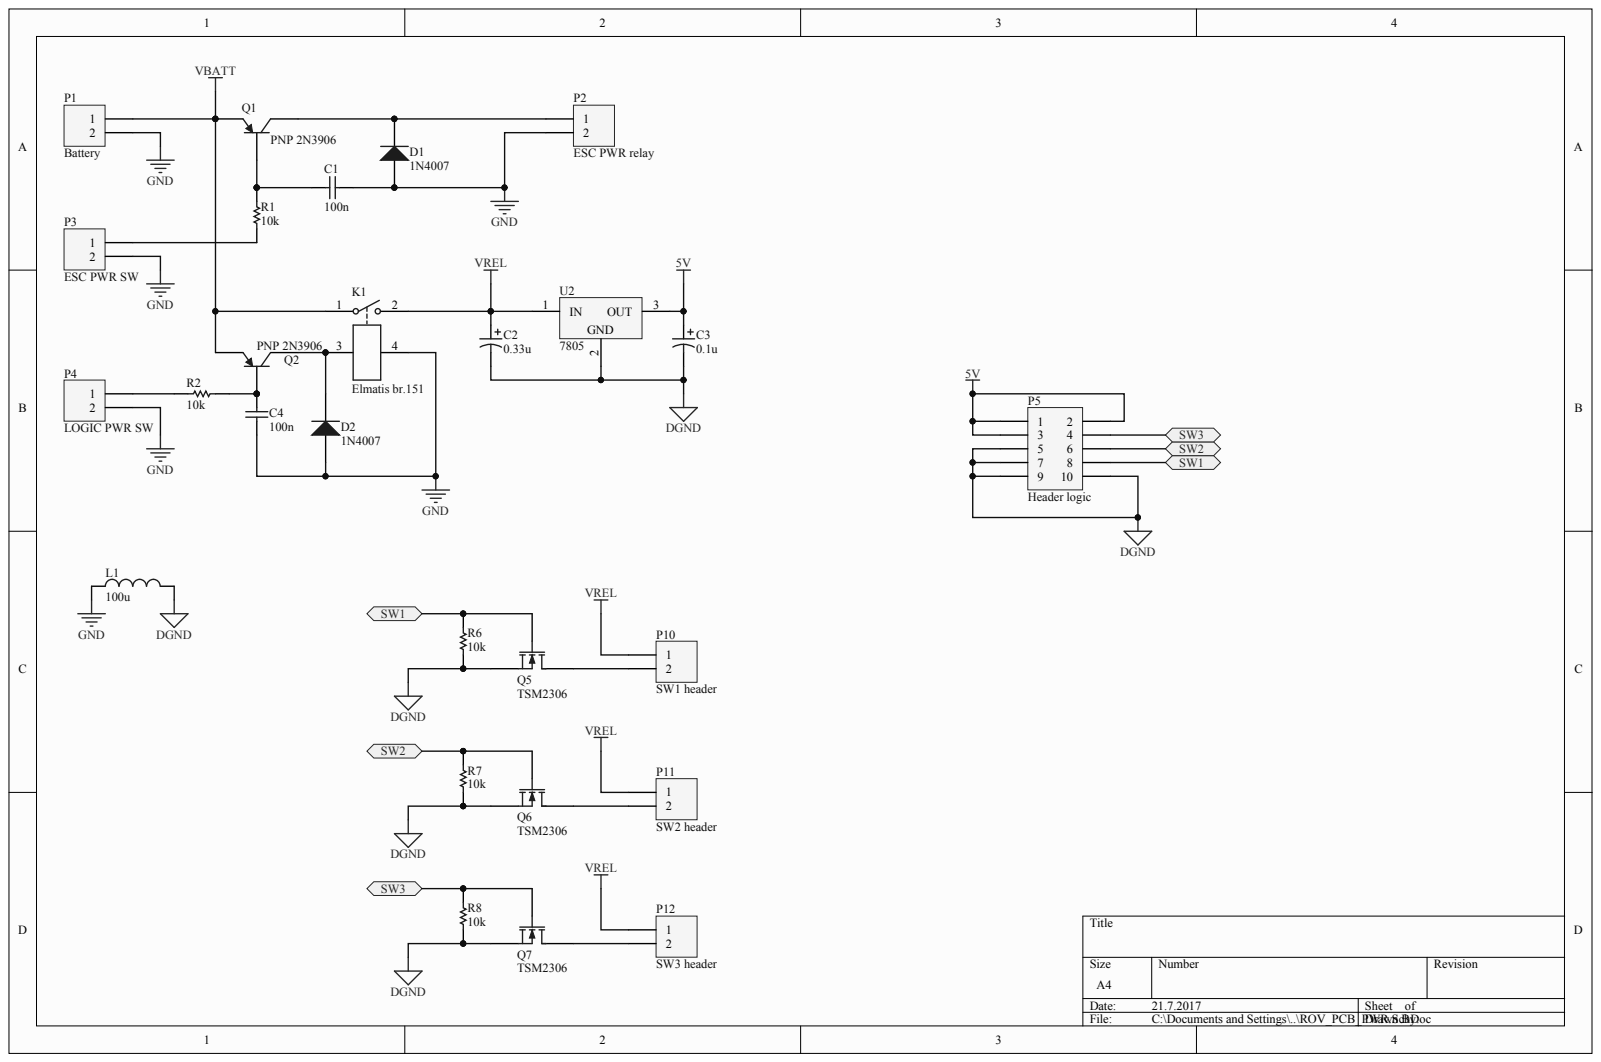
[picture p54: page 4]

V_PCB_PWR.SchD Drawn By:oc
