LVH-27/S3-ROV/(list of files, drawings)

Other design files:
2016/ROV_PCB/PcbLib1.PcbLib
2016/ROV_PCB/ROV_PCB.PcbDoc
2016/ROV_PCB/ROV_PCB.PrjPcb
2016/ROV_PCB/ROV_PCB.SchDoc
2016/ROV_PCB/Schlib1.SchLib
2017/hw/NO EDIT - ROV/Embedded_custom.SchLib
2017/hw/NO EDIT - ROV/PCB_template.PcbDoc
2017/hw/NO EDIT - ROV/ROV_custom.PcbLib
2017/hw/NO EDIT - ROV/ROV_PCB_3.PcbDoc
2017/hw/NO EDIT - ROV/ROV_PCB_3.PrjPcb
2017/hw/NO EDIT - ROV/ROV_PCB_3.SchDoc
2017/hw/NO EDIT - ROV/ROV_PCB_CHARGE/ROV_PCB_CHARGE.PcbDoc
2017/hw/NO EDIT - ROV/ROV_PCB_CHARGE/ROV_PCB_CHARGE.PrjPcb
2017/hw/NO EDIT - ROV/ROV_PCB_CHARGE/ROV_PCB_CHARGE.SchDoc
2017/hw/NO EDIT - ROV/ROV_PCB_PWR/ROV_PCB_PWR.PcbDoc
2017/hw/NO EDIT - ROV/ROV_PCB_PWR/ROV_PCB_PWR.PrjPcb
2017/hw/NO EDIT - ROV/ROV_PCB_PWR/ROV_PCB_PWR.SchDoc
skladiste/s3 2015/konverter.pcb
skladiste/s3 2015/prilagodba.pcb
skladiste/s3 2015/relay.pcb
skladiste/s3 2015/Relejni sklop/relej - jedan.pcb
skladiste/s3 2015/Relejni sklop/relej - slozeni.pcb
skladiste/s3 2015/RS232-TTL.pcb
skladiste/s3 2015/shema1.pcb
skladiste/s3 2015/shema2.pcb
skladiste/s3 2015/shemabolja.pcb
skladiste/s3 2015/shemakrug.pcb
