LVH-27/S3-ROV/(commit log)

2016-07-20 Initial Arduino serial connection source
2016-07-27 Rewritten arduino code
2016-07-27 Added LED toggle, Compile fix
    [arduino_serial.ino]
2016-07-28 Working ESC control
2016-07-29 I2C coded
2016-07-31 Done arduino code
2016-08-03 Sizeof(type) instead of hardcoding. close(sock_desc) removed because the compiler decided it didn't like it.
    [rov.cpp]
2016-08-05 Added battery monitor Arduino program.
2016-08-07 I2C working in both ways; sending voltage back to RPi.
2016-08-07 I2C working in both ways; Arduino sending voltage back to RPi.
2016-08-07 Removing battery status file - merged with main I2C file.
2016-08-07 I2C working on RPi side.
2016-08-07 Added a skeleton of camera servo/stepper motor code.
2016-08-08 Stepper chip added.
2017-07-23 Added 2017 project files. RPi is out of the picture - input mapping is done on the computer instead, whereas motor, camera and sensor control remains on the Arduino.
    [Embedded_custom.SchLib, PCB_template.PcbDoc, ROV_PCB_3.PcbDoc, ROV_PCB_3.PrjPcb, ROV_PCB_3.SchDoc, ROV_PCB_3.csv, ROV_PCB_3.xlsx, ROV_PCB_CHARGE.PcbDoc]
2017-07-23 added semi-functional Arduino ROV Serial library and it's python counterpart.
    Tested only to send to arduino (with provided python script), and fill the data structure. Added some error checking. Not too efficient
    [ROVserial.py, basic_comm.ino, rov_comm.cpp, rov_comm.h]
2017-07-23 Implemented mapping to motors.
2017-07-23 Motors mostly working - over the USB cable. USB-to-TTL crappy.
2017-08-02 F@$*!ng serial communication just won't behave no matter what. Postponing work on project for now.
    [rov_comm.cpp, rov_comm.h]
